xccloop/EdgeLink/edgenode/Drivers/SYSTEM/README.md

# SYSTEM

Put reusable support modules here when needed. No delay, UART, or other
application support code has been generated by the environment setup.
