xccloop/EdgeLink/edgenode/OCD/startup/README.md

# Startup file

`startup_gd32f10x_hd.s` is already present and is the high-density variant for
GD32F103RCT6. The Makefile and linker script are wired for this filename.
