xccloop/EdgeLink/docs/develop/README.md

本文件夹用于记录开发日志
（这里的日志区别于学习日志，主要是写BSP/APP初步写完+硬件初步完成后进行开发尝试）
