xccloop/EdgeLink/OTA_LOG.md

此文件记录OTA升级

BETA:
2026-10-12：V1-V2
compiled.ps1文件第四十一行修改
& $make_path -B SLOT=all IMAGE_VERSION=2 all
此版本不涉及代码修改仅仅为OTA升级测试

2026-10-12：V2-V3
此次将edgenode的HMI先显示启动画面等一切完成后再显示业务画面，不再出现以前的未初始化花屏现象

2026-10-12：V3-V4
此时移除固件传输完毕后自动重启而是等用户自行重启，新增IPS提示

2026-10-12：V4-V5
本次为故障测试用

2026-10-12：V5-V6
本次为故障测试

2026-10-12:V6-V7
修正node的tcp服务器ip

2026-10-14:V7-V8
新增TCP固件链路，修复重连扫描flash异常阻塞

2026-10-14:V8-V9
修复重连扫描flash导致采集发送阻塞的问题

2026-10-14:V9-V10
测试

2026-10-14：V10-V11
修改连接wifi名

2026-10-14:V11-V12
修改连接wifi名
