xccloop/EdgeLink/docs/develop/2026-10-13/main.md

# 2026-10-13

## 今日安排

今天解决两个主线问题

1. 重连扫描flash全部导致异常堵塞
2. TCP链路ota下发
3. 如果有时间研究一下固件签名

先做第二个吧

## 1. TCP链路OTA下发

### 1.1 Node：沿用现有 OTA 流程

昨天我们完成了TCP链路的槽位查询，今天先来想一下接受逻辑
我们知道现有的ota他是存储满768之后然后进行存储，在不改变ota大体框架的情况下，我们进行对于tcp的链路，自然希望也沿用这个设计

```text
存储到768-进行外置flash存储-IPS显示新固件到来-下次重启后bootloader读取新固件
```

这套流程基本上都是可以复用的，唯一要注意的是tcp的堵塞问题
因为我们需要一次存储768个字节，这对于flash的SPI速率来说是有限制的，但是hub的下发又不会停止，就导致数据大量丢失
虽然我们也可以用can的那一套我收到了x序列号固件，但这样做效率还是太低

我们更换思路，人为封装一帧下发给node，node确认完毕之后再继续发，这样做就可以避免刚才的tcp堵塞问题
说着还是挺简单的，让我们来做node适配吧

### 1.2 TCP 帧格式与接收分流

首先我们看一下现有的`ota_tcp_on_frame`，这个函数昨天已经用来处理槽位查询了，所以我们不需要再创建一个入口，直接通过type来区分就好
`0x01`继续处理槽位查询，`0x02`则处理固件数据

不过这里有一个问题，TCP传输的是字节流，我们人为封装的一帧，并不意味着node能一次收到完整的一帧
比如hub发送768个字节，node可能分好几次才收完，所以不能把一次`+IPD`当成一帧固件，我们需要自己把这一帧拼完整

这就需要先确定帧格式，我们除了发送固件本身，还要告诉node这是哪一次传输、第几个块，以及这一块有多少有效数据
因此数据帧就设计为：

```text
type-传输编号-块序列号-有效长度-固件数据
```

这里的768指的是固件数据，不包含前面的帧头
而且最后一块不一定刚好有768个字节，所以有效长度这个字段不能省略，否则node就不知道最后哪些字节才是真正需要存储的

### 1.3 完整块交接与 Flash 写入

接下来就是接收部分，串口中断每收到一个字节，就交给`tcp_receive_byte_from_isr`处理
它先识别type，发现是固件数据以后，先收齐帧头，再根据有效长度把后面的数据收齐
固件里面即使出现了`0x01`或者`0x02`，也不能再当成新的type，因为此时我们已经进入了接收数据的阶段

收齐以后也不能直接在中断里面写flash，中断只负责接收和通知
我们把完整块的位置、长度和连接编号放进队列，由OtaTask取出来，再交给已有的`ota_tcp_on_frame`处理
这里队列传递的是缓冲区的位置，并没有把768个字节再复制进队列，所以在OtaTask处理完成之前，这块接收缓冲不能被覆盖

随后就进入我们熟悉的ota流程了，检查块序列号，检查镜像头，然后调用现有的外置flash写入函数
**注意，回复成功的时间必须放在flash写入成功之后，不能刚收齐数据就告诉hub成功，否则hub继续发送，还是可能遇到缓冲被占用的问题**

回复也不用设计得太复杂，带上对应的传输编号、块号和状态就好
1表示成功，2表示失败，hub收到成功以后才继续发送下一块，没有收到回复就等待超时后重发

### 1.4 重复块与尾块校验

但重发还有一个细节，假如node已经存储成功，只是回复没有到达hub，那么hub就会再发一次相同的块
这时候node不能再推进存储位置，只需要补发一次成功回复，否则同一块固件就会被重复计算

最后一块则需要多做一步，除了把剩余数据写入flash，还要沿用现有的读回CRC校验
只有整个镜像校验通过，才回复最后一块成功，随后IPS提示新固件到来，等待我们手动重启

这样我们增加的主要就是TCP组帧、完整块交接和块号回复，原有的flash存储、镜像校验以及bootloader安装流程都可以继续使用
这里也不需要先断言当前速率一定会大量丢包，我们通过一块一确认，让hub的发送节奏跟随node的实际处理能力，就不用依赖flash每一次都能及时写完了

### 1.5 Hub：HTTP 请求与发送状态

现在我们转头去看hub，node的接受和应答已经处理好了
接下来我们要做的就是hub的crul命令了控制下发

首先这里要区分一下，curl并不直接把固件发送给node，它只是向hub发起一个HTTP请求，告诉hub给哪个node发送哪一个文件
真正读取固件和发送数据的，还是hub自己

因此我们沿用现有的路径：

```http
POST /hub/firmware/tcp/send/node/1
```

这里最后的1就是目标节点编号，请求正文则放hub本地的镜像文件路径
注意，这个路径必须是hub上的路径，不是我们电脑上的路径，而且发送的应该是带镜像头的固件文件

接下来先看HttpHandle，它负责把请求解析成业务意图
发现是TCP下发路径，就从路径中取出node编号，把正文保存为固件路径
这里不打开文件，也不等待node回复，否则HTTP处理函数就会被整个固件传输过程占住

随后Gateruntime拿到这个发送意图，为这次请求分配一个`request_id`，再找到目标node已经建立的TCP连接
这里我们不需要重新连接node，因为node平时上传温度数据用的就是这条连接，固件下发也可以沿用它

找到连接以后，Gateruntime调用ota的`sendFirmwareTcp`，检查文件是否存在、是不是普通文件、长度和镜像头是否合法
检查通过后，把文件句柄、文件总长、目标node和当前块号保存下来

这里需要注意，调用这个函数并不代表固件已经发出去了，它只是建立了本次发送状态
这也是我一开始看ota类比较绕的地方，它并不会自己一直运行，而是由Gateruntime的事件循环不断调用它
第一次调用可能只是建立状态，后面调用时准备数据，收到node回复以后再调用它更新进度
这些调用之间，靠ota对象里面保存的状态衔接起来

其中还有两个编号需要区分，`request_id`用来关联hub内部的HTTP请求，`transfer_id`则会跟着固件帧一起发送给node
前者用于最后找到应该给哪个curl请求返回结果，后者用于判断收到的回复是不是属于这一次固件传输

### 1.6 分块发送与非阻塞续发

状态建立好以后，事件循环开始推进发送
ota从镜像文件的第0个字节开始，每次读取最多768个字节，再按照我们前面约定的格式封装：

```text
type-传输编号-块序列号-有效长度-固件数据
```

普通块的数据长度是768，最后一块则按照文件剩余长度读取
当前块没有确认成功之前，不能推进已确认位置，也不能直接开始准备下一块

封装好以后，ota把数据帧交给Gateruntime，由Gateruntime通过目标连接发送
这也是当前TCP和CAN实现的一处区别，CAN发送时ota可以直接调用`can.send`，而TCP的socket由Gateruntime管理，所以ota负责准备帧，Gateruntime负责真正发送

不过发送这里还有一个细节，hub使用的是非阻塞socket，一次发送不一定能把整帧全部交出去
比如完整帧有777个字节，这次只发出了300个字节，那么下次应该继续发送剩余的477个字节，而不是重新发送一整帧
因此这里还要记录当前已经发送了多少字节，遇到`EAGAIN`就等待可写事件，再继续往后发送
只有整帧都提交给socket以后，才开始计算等待node应答的时间

这里也要区分，发送半帧以后继续发送剩余部分叫续发，完整帧发完但没有收到应答，再从头发送这一块才叫重传

此外这条TCP连接还承载着温度数据的应答，所以固件帧没有发完时，不能把温度ACK插进它的中间
我们让同一连接上的发送数据按顺序进入缓冲，当前帧先发完，再发送后面的内容，这样node才能正确拼出完整帧

### 1.7 回复处理与结果返回

随后hub就等待node的回复了
Gateruntime从TCP字节流中取出完整的8字节回复，再交给ota检查传输编号、块号和状态
如果当前块回复成功，就推进文件位置和块号，下一次事件循环再准备下一块
如果没有收到回复，就等待超时后重发当前块，但重传也要有次数上限，不能一直卡在这里

对于失败回复，我们根据node返回的期待块号处理

- 如果仍然期待当前块，就可以有限次数重发
- 如果node已经清理了接收状态，要求从第0块开始，那么本次传输就结束，等我们下一次重新发起，不在中途自动换成另一场传输

最后一块的成功回复则比较特殊，因为node只有完成整个镜像的Flash读回CRC校验以后才会回复成功
所以hub收到它以后，就可以认为这次镜像接收和校验完成了
**但这仍然不代表新固件已经运行，后面还需要手动重启，由bootloader完成安装和试启动**

最后ota把结果填写到Result里面，Gateruntime根据`request_id`找到等待中的HTTP请求，把结果转换成JSON返回给curl

### 1.8 完整链路与待验证项

这样整条链路就接起来了：

```text
curl发起请求-HTTP解析发送意图-ota建立状态-事件循环分块发送-node写入后应答-hub推进下一块-最后返回下发结果
```

目前两端的代码已经接通，编译和静态审查也完成了，但还没有进行实际下发验证
后面真机验证时，再重点观察块号推进、重复块应答、尾块校验，以及传输中途断线后的重新发送情况

还算是比较简单，基本的链路都可以复用

## 2. 重连扫描外置flash导致异常阻塞的问题

### 2.1 现有阻塞在哪里

接下来我们看一下重连的问题，现在重连以后LogTask会去找没有发送成功的pending记录，然后进行补发
这里有一个问题，现有的`log_find_next_pending`每次读取16个字节，如果没有找到就一直往后找，中间没有主动休眠
而LogTask的优先级为4，IPS和TransmitTask的优先级为3，所以当pending在比较靠后的位置时，LogTask就会连续读取很多次flash，导致其他任务不能及时运行

虽然`gd25_read`每次结束都会释放SPI锁，但释放锁并不意味着LogTask会主动停下来，因此不能只靠这个解决堵塞
当然也不是每次重连都一定扫描完整个日志区，pending数量为0时现在已经会直接返回，主要问题还是有pending但是位置比较分散的情况

### 2.2 先找全，再集中补发

一开始考虑的是找到一条就发送，然后继续找下一条，但我这里希望的是先把所有pending找全，再统一进行补发
比如2号发送失败，3号成功，4号之后又一直失败，那么2号也必须包含在这次补发里面，不能直接从4号开始向后找就结束

因此这里确定为两个阶段：先分步扫描全部日志区，建立索引，扫描完成后再集中补发
补发期间正常采集和发送可以暂时停止，补完以后恢复，但IPS和其他任务还是要能继续运行
**这里的一次性补发是一次触发后持续处理全部pending，发送上仍然沿用现有的一条发送、一条确认，并不是同时把所有记录塞给TransmitTask**

### 2.3 RAM 页位图与空间计算

接下来考虑找到的pending要保存多少信息
如果把所有记录都保存到RAM里面，空间肯定是不够的，甚至只保存每条记录的地址，积压很多的时候也会放不下

现在日志区是[0x000000, 0x3BF000)，后面还有OTA暂存区，因此不能把整颗4MiB都当成日志
一页按256个字节计算，日志区一共有15344页，每页16条记录，也就是245504个槽位

如果每个槽位用一个bit记录有没有pending，需要30688个字节
但芯片总共只有48KB的RAM，现有构建的data和bss已经占了大约25.5KB，剩下还要给主栈等使用，所以这个方案也不合适

我们再缩小一下，不保存每一条的位置，只保存哪一页有pending
每页使用一个bit，15344页只需要1918个字节，这样就比较合适了
这个数组也就是页位图，0表示这一页扫描时没有发现有效pending，1表示这一页至少有一条有效pending

```c
static uint8_t pending_page_bitmap[1918];
```

比如第page_index页，对应数组的`page_index / 8`这个字节，再用`page_index % 8`确定这个字节中的哪一位
补发时根据页号计算地址：`LOG_BASE_ADDRESS + page_index * 256`
这样我们保存的是页的位置，而不是温度、sequence或者每条记录的完整内容

### 2.4 第一阶段：分步扫描，建立完整索引

第一阶段就是建立这个数组
开始新一轮扫描前先清空位图，准备从日志起点开始，pending数量为0时则可以直接结束，不需要白扫一遍
为了让这次扫描的范围稳定，扫描和补发期间先暂停发放新的采集许可，已经产生的采样要先正常落盘，不能因为开始补发就把它丢掉
之前已经投递给TransmitTask的记录仍然可能返回确认事件，这些事件也要正常处理，不能让确认队列一直积压

然后每次从GD25读取一页到256字节缓冲里面，在RAM中检查这一页的16条记录
先判断是不是全FF，再检查CRC，只有有效记录并且状态不是confirmed时，才算pending
发现这一页有pending，就把对应的bit置为1，这个阶段不发送记录

这页检查完成后，`gd25_read`已经释放SPI锁，再调用`vTaskDelay(1)`，让IPS和通信任务有机会运行，随后接着扫描下一页
当前FreeRTOS为1000Hz，1个tick对应1ms，不过`vTaskDelay(1)`是等到下一个tick，并不保证完整睡够1ms
不能拿着SPI锁休眠，否则其他使用SPI的任务还是会被挡住

也不能遇到空槽或者confirmed就停止整个扫描，因为后面仍然可能有零散pending或者回环前留下的记录
一直检查到`LOG_END_ADDRESS`，整个日志区扫描完成，才进入补发阶段

**如果读取失败，这次索引就是不完整的，不能拿它当成已经找全的结果，应该报告存储异常并停止本次流程**

### 2.5 第二阶段：按索引集中补发

第二阶段就是按照这个位图集中补发
先在RAM数组里找到一个标记为1的页，然后从GD25读取这一页，再检查里面具体哪些记录还是pending
这里不能只读数组就直接发送，因为数组只有位置，真正的温度、sequence和状态仍然在flash里面

补发前也要重新检查CRC和状态，因为建立索引以后，之前在途记录的确认事件可能已经把其中一些记录改成confirmed
对于仍然有效的pending，解码成Message，带上它的flash地址，交给现有TransmitTask发送

等到对应地址和sequence的成功结果后，仍然由LogTask调用`log_confirm`，把flash中的状态改成confirmed，pending数量也在确认成功后减少
不能刚放进发送队列就减少pending，也不能收到别的记录的确认就推进当前记录

一条确认完以后，继续检查这一页后面的记录，这一页里面的pending都处理完，再处理下一张有标记的页
这样2号和4号即使中间隔着已经确认的3号，也都会参与补发，页的物理顺序不一定等于回环后的sequence顺序，这里保证覆盖全部，不额外承诺严格按sequence排序

### 2.6 补发期间的调度与缓存

不过补发阶段也不能忘了堵塞的问题
读取一页以后最多检查16条记录，定位范围已经限定在这一页，不会再为了找下一条去连续搜索大量无pending的页
发送等待ACK时现有的队列等待会让任务休眠，IPS可以继续运行，但快速收到ACK时也不能只依赖这个

因此每处理完一张标记页，还是释放总线并休眠1个tick，再继续处理下一页
没有pending的页可以通过RAM位图跳过，不需要重新读取GD25搜索

页缓冲在本页处理结束之前不能被其他函数覆盖，不能把一条记录确认完回来以后，继续解析已经被改掉的缓冲
这一点实现时要检查现有`log_scan_page`的使用位置，必要时给补发单独保留256字节缓冲

### 2.7 失败退出与采集恢复

还有失败以后怎么处理
只有这一页的有效pending都确认成功，才可以清掉这一页的bit，不能发成功一条就清掉整页

暂时沿用现有的连续失败三次退出策略，这时表示本次补发中断，剩余记录仍然是pending，不代表全部补发完成
未处理完的页标记也要保留，下次触发时可以重新建立索引再尝试，不能把失败当成成功跳过去

退出补发以后，恢复采集仍然要经过现有的`log_write_pending_ready`检查，目标扇区还有pending时不能直接擦除
补发过程中再次出现`link_restored`，也不要在当前调用里重新开启一套嵌套扫描，先记住通知，当前流程退出后再判断是否还需要新一轮恢复

### 2.8 RAM 索引与断电恢复

这里我也考虑过把位图存进flash，这样重启以后就不用重建了
但真正需要持久保存的数据本来就在GD25里面，RAM里的位图只是这一轮恢复用的索引

如果这一轮发送失败但没有重启，位图还能保留；如果断电重启，位图虽然没了，但没有确认的记录仍然是pending，重新扫描就能恢复

反而把位图持久化以后，还要考虑记录写成功但位图没更新就断电的情况，直接相信旧索引就可能漏掉记录
所以这次先使用RAM位图，重启仍然沿用开机扫描恢复，不把持久化索引的问题一起加进来

### 2.9 耗时估算与验证边界

最后再区分一下扫描耗时和系统堵塞
当前SPI0为72MHz时钟16分频，也就是4.5MHz，读取一页加上命令和地址，纯传输时间大约0.462ms
实际还有逐字节轮询、函数调用和16条记录的CRC检查，之前估计是1到3ms量级，但这个还没有上板测量，不能当作实测结果或者最大耗时

完整扫描15344页仍然需要等待，如果每页连同调度平均2ms，就大约是30.7秒，这只是举例，不是现在已经测出来的时间
所以这个方案解决的是扫描期间其他任务长时间不能运行，并不会让首次补发立即开始，还是要等页索引全部建立完成
补发总时间也仍然受积压量和ACK速度影响，Flash写擦、SPI锁等待以及发送函数本身的同步耗时也不会因为加了位图就消失

### 2.10 完整流程与测试计划

现在整条流程就确定为：

```text
重连触发-暂停新采集并处理已有采样和确认-每次扫描一页并休眠-建立完整RAM页位图-按位图读取目标页-逐条补发并确认-页间休眠-全部完成或失败退出-检查可写条件后恢复正常采集
```

主要修改集中在`log.c`、`log.h`和`log_task.c`，保留现有16字节记录格式、TCP/CAN发送协议以及ACK确认方式
**目前这里只把修改逻辑整理好了，代码还没有实现，也没有真机验证**

后面重点测试2号失败3号成功4号以后失败这种零散pending，pending位于日志尾部，大量积压，以及日志回环后的情况
再检查扫描和补发期间IPS是否持续刷新，确认事件是否正常处理，一页部分失败时标记是否保留，断电后是否能重新找到未确认记录
同时记录单页扫描耗时、建立索引总时间和补发总时间，再根据实际结果调整每页之间的等待

### 2.11 代码实现

接下来按照这个方案把代码接上了
`log.c`里面增加了1918字节页位图和独立的256字节补发缓存，`log_pending_scan_begin`开始新一轮建图，`log_pending_scan_step`每次最多读取一页
这一步只建立索引，不发送，全部完成后才能使用`log_pending_replay_next`按标记页取记录
它返回`LOG_MORE`时表示还要继续，和`LOG_NO_PENDING`区分开，LogTask会先休眠1个tick再继续
原来重连入口先调用`log_find_oldest_pending`，现在已经替换成暂停采集、完整建图、集中补发，不会先走一遍旧的无休眠搜索

上电恢复则直接复用`log_init`扫描时顺便建立的位图，避免开机再扫一次，不过原有开机恢复扫描本身仍然是同步的，这次没有把它也改成分步初始化
确认事件在扫描页之间也会处理，如果另一条在途记录恰好属于当前补发缓存页，确认成功后会同步修改缓存状态，后面就不会再按旧状态把它取出来

暂停采集时也处理了已经发出去的许可，没有被CollectTask取走就撤回，已经取走就等待这次采样落盘或者失败归还许可，之后不再发新许可
补发结束或者连续失败三次退出后，仍然先检查下一个槽位是否可写，再恢复采集

### 2.12 编译、主机回归与待做的真机验证

现在plain、A、B三种布局编译通过，data为116字节，bss为28232字节，静态RAM合计28348字节，大约27.7KB

新增了`test_log_replay.py`，使用模拟GD25和队列运行真实`log.c`、`log_task.c`，检查每次扫描最多一页，完整扫描完成前不开始补发
零散pending、日志最后一页、同页多条、其他记录的确认更新缓存、连续失败三次后重新恢复、扫描读取失败和CRC损坏都做了主机回归
还检查了撤回采集许可、失败归还许可，以及已经在途的采样先落盘，最后跑了LogTask上电、重连、恢复采集这一条调用流程

这些主机测试通过，原有TCP重连回归也通过，代码和安全并行审查没有发现需要修复的高、中风险问题

**这里模拟的仍然是主机队列和flash，不能证明真实FreeRTOS抢占、单页最大耗时或者IPS已经不再卡顿**
下一步需要烧录后制造零散和大量pending，观察重连建图期间IPS是否持续刷新，建图完成后积压是否逐步减少，再保留扫描耗时、串口和Hub确认记录
