xccloop/EdgeLink/docs/develop/2026-10-14/main.md

2026-10-14

昨天写的一个新功能和修复一个bug还没有进行测试
今天先进行测试，然后把固件签名给做好

## 1.补发期间继续采集和正常发送

先测试了昨天的重连处理，发现现在重连时已经不会严重卡死，HMI和LED还能运行
但温度采集和新的记录会停下来，pending也不会继续增加，只有历史pending补发完以后才恢复
这里要分清楚，这不是LogTask死锁，而是昨天确定的暂停采集策略，CollectTask没有得到新的许可，所以没有产生这段时间的样本
现在我希望把这段采样空窗去掉，历史恢复期间新采样也照常落盘和发送

### 修改思路

不能只在原来的补发循环里增加休眠，因为那样只是让其他任务能运行，LogTask还是没有回来处理新采样
因此把补发拆成空闲、建图、找下一条、等待投递、等待结果这几个状态，每轮主循环只推进一步
主循环先处理确认，再处理新采样和正常发送，最后推进历史扫描或者补发
等待历史ACK的时候，不再让LogTask停在confirm_queue的portMAX_DELAY上，真正的网络等待还是交给TransmitTask

这里也要考虑新数据不断增加的问题，不能用全局pending数量归零来判断历史是否补完，否则新采样会让这一轮一直结束不了
我们在开始建图时记住当前最大已落盘sequence，比如100，这次只处理不超过100的历史记录
之后101、102这些仍然正常落盘和发送，但不加入这一次历史补发，发送失败也保留在Flash里面
等后续正常通信成功或者再次重连时，再安排新一轮恢复，离线期间不自动无限循环建图

### 队列、缓存和空间边界

正常工作优先，历史最多一条在途，已有正常发送结果都处理完以后才投递历史，避免同一条旧记录的结果相互混淆
队列投递改成零等待，满了就把已经落盘的普通工作保留在LogTask里，下一轮再试，不能丢掉也不能直接当成发送成功
这时暂缓下一次采集许可，这是实际发送容量不足产生的背压，和每次补发都主动暂停采集不同
如果普通数据长期占满链路，历史发送也可能一直等不到空隙，这个要靠实测吞吐判断，不能保证两路都不受带宽限制

允许新写入以后，原来每写一条就把索引置为无效的逻辑也要去掉，改成只处理固定历史范围
同页追加或者整扇区擦除会使对应补发缓存失效，但保留游标，下一次重新读取实际内容
其他确认仍然按地址和sequence检查，槽位已经擦掉或者复用了就返回LOG_STALE，不修改新记录，也不把这种旧结果当成Flash读取失败
目标扇区仍然含pending时继续禁止擦除，用LOG_FULL和真正的IO失败区分，等确认释放空间以后再重新检查采集许可
历史记录连续失败三次仍然结束本轮恢复，不影响正常主循环继续处理采集和发送

上电初始化也一起接上，恢复序号以后先放行HMI和可写时的采集，再单步推进历史发送，不再补完全部记录以后才放行
不过上电那次恢复写指针和sequence的全区扫描本身没有改成异步，这个和运行期补发分开看

### 实现和验证

主要修改了log_task.c、log.c和log.h，没有增加任务，也没有修改16字节记录、TCP/CAN帧或者线上ACK
主机回归先复现了扫描期间写入新样本会混入历史范围的问题，再检查新样本不会使快照失效、不会延长这一轮历史
随后用模拟GD25、有限队列和模拟调度运行真实LogTask，检查扫描和历史ACK等待期间继续产生、落盘并投递正常记录
还覆盖了历史连续三次失败、队列满后重新投递、同页追加、整扇区复用、旧确认、空日志以及读取失败
满扇区的测试保留了暂停保护，并检查历史确认释放空间后采集许可能够重新发出
日志、TCP重连和OTA手动重启三项主机回归通过，plain、A、B三种APP编译通过，代码和安全并行审查没有发现需要修复的高、中风险问题
以上是主机模拟和编译结果，实际运行情况继续结合下面的实测观察记录，不能直接当成所有场景都已经通过。

### 实测观察和恢复版本

之前看到BACKLOG没有变化，以为采集和发送又卡住了，后来确认其实数据已经发出去了。
持续采集版也观察到BACKLOG反复0和1跳变有所改善，因此暂时撤回回退决定，恢复持续采集版继续测试。
BACKLOG显示的是未确认记录总数，新记录增加和历史确认减少可能相互抵消，不能只看这个数字判断是否卡死。

分步扫描后偶尔仍有短暂停顿，IPS和LED都会停一下。目前感觉主要影响观感，也不是不可接受。
先检查代码中没有分步的路径：

- 进入扇区前的pending检查会连续读完整4KiB，最多16页，中间没有休眠；可写检查和实际写入前都可能执行。
- GD25写入和扇区擦除仍在等待WIP清零时忙等，LogTask优先级4高于HMI的3和LED的2，可能同时推迟屏幕刷新和LED任务。
- 每条新记录的printf也是轮询串口发送；一轮还可能连续处理多条确认，每条确认都要写Flash。

这些是源码发现的候选原因，目前没有测出真机各段耗时，不能直接把偶发卡顿归到其中一个。
IPS使用SPI2，Flash使用SPI0，这里不能直接归因于屏幕和Flash抢同一条SPI总线。

### 当前决定

先保留补发期间继续采集和正常发送这一版，不再回退，也暂时不继续修改驱动。
偶发卡顿先记作待优化项，目前没有测出具体耗时，也还没有确认是哪一段造成的。
后面如果出现明显长停顿，或者发现采集、通信受到影响，再测量单页扫描、扇区检查、擦除、写入、确认和串口打印的最长耗时，找到原因以后做局部修改。

这次也提醒我，不能只看BACKLOG数字有没有变化来判断系统是否卡死，还要结合Hub是否持续收到数据、采样序号是否增长。
现在只记录已经观察到的现象，持续采样、大量积压和空间边界等情况还需要继续验证。

## 2.测试TCP下发固件

今天测试Hub通过TCP给3号Node下发A槽v9固件，命令如下：

```powershell
curl.exe -i -X POST http://192.168.1.4:8080/hub/firmware/tcp/send/node/3 --data-raw "/home/root/firmware/node_a_v9.bin"
```

返回结果：

```http
HTTP/1.1 200 OK
Content-Length: 74
Connection: keep-alive
Content-Type: application/json
Keep-Alive: timeout=4
Proxy-Connection: keep-alive

{"submitted":true,"node":3,"submitted_bytes":49480,"relay_verified":true}
```

这次TCP下发正常，49480字节的镜像已经提交，Node返回中转镜像校验成功。
这里确认的是TCP传输和中转区校验这一段，重启后的Bootloader安装、实际运行版本和试运行确认还要结合节点状态判断，不能只靠这个HTTP返回就认定全部升级完成。

### 掉电保护测试范围

这次TCP OTA不再重复做掉电保护测试。之前CAN OTA已经尝试过接收中途断电、Bootloader搬运中途断电后恢复等情况，相关记录见[10月12日开发笔记](../2026-10-12/main.md)。
TCP和CAN接收后使用相同的中转镜像、Bootloader安装和恢复逻辑，所以这次先复用之前公共流程的验证记录，重点确认TCP下发是否正常。
不过TCP自身接收中断、重连等情况不等于已经通过掉电测试，这部分仍然记为本次未测。

## 3.增加OTA固件签名

TCP下发已经测试到中转镜像校验成功，接下来补上固件来源认证。之前只有CRC，别人修改固件以后重新计算CRC还是能通过，所以现在增加ECDSA P-256和SHA-256。

库源码也放在Common里面，具体是Common/Crypto/micro-ecc和Common/Crypto/sha256。Common/OTA负责签名格式、固定公钥和分块验签接口，APP和Bootloader各自编译同一份源码，不在设备上保存私钥。

### 打包和校验逻辑

镜像头格式升到v2，总长仍然256字节。前28字节的原字段不动，随后增加4字节算法编号和64字节签名，剩下156字节保留区，最后还是header_crc32。
签名覆盖清零签名字段后的前252字节镜像头和完整APP，绑定型号、版本、目标槽、长度和应用内容。私钥签名以后填入签名，最后再计算头CRC。

私钥生成在仓库外的本机.edgelink/keys/ota-signing.pem，仓库只保留公钥。compiled.ps1仍然可以用-v10编译，也能通过-SigningKey指定私钥路径。缺少私钥或者公私钥不配对会报错，不生成无签名镜像。

校验分三处：

1. APP收完以后，从GD25读回镜像头和完整应用，验签成功才认为接收完成、提示重启。
2. Bootloader搬运前重新读取中转镜像并验签，失败不能擦除目标槽。
3. 搬运后及每次启动检查内部A/B槽时验签，回退槽也要通过校验。

Hub最初只同步接受v2镜像头，随后补上了下发前的完整验签，具体见下面的补充记录。TCP和CAN帧格式没有改变。

### 容量和验证

最初只给密码学库开启体积优化，Bootloader超出16KiB约468字节；改为Bootloader整体使用-Os后能够放下，分区地址没有调整。
编译器栈报告显示验签多了大整数运算的调用层次，因此OtaTask从512words增加到768words，也就是3KiB，实际最低栈水位仍要上板观察。

主机测试使用独立测试密钥，已经检查正确签名、错误密钥、旧格式、损坏签名，以及修改应用或镜像头再重新计算CRC后仍被拒绝。
还运行真实APP的CAN/TCP接收路径和Bootloader安装/槽校验路径，检查坏签名不能返回成功、不能触发目标槽擦除、不能启动内部假镜像。
签名库的版本和许可证保留在Common/Crypto中，SHA-256做了标准头文件移植和字节移位前转无符号的局部修正。

首次启用要配套烧录新Bootloader和签名APP，同时更新Hub，旧无签名APP不会被新Bootloader接受。还没有做签名版本的实机升级、验签耗时和栈水位测试；今天前面TCP下发成功的记录对应的是增加签名之前的版本。
这次先解决网络伪造固件，不加入防回滚、固件加密和SWD物理防护。

最终验证：签名交叉校验、Bootloader验签、OTA接收与重启提示、日志补发、TCP重连五项主机回归通过；compiled.ps1 -v10编译plain/A/B通过，A/B镜像主机验签通过，Bootloader产物15464字节，Hub在WSL原生编译通过。代码和安全审查未发现高、中风险问题，SHA-256移位问题已修正。这些修改尚未烧录，也没有部署到Hub。

### 这次遇到的问题

一开始感觉就是加一个库然后调用函数，真正接进去以后发现，算法调用本身比较简单，反而是空间、栈和两边格式一致这些地方需要处理。

#### 1.Bootloader空间不够

Bootloader只预留了16KiB，最初只给密码学库加-Os，其余代码仍然按原来的-Og编译，链接时报FLASH超出468字节。
这里没有直接扩大Bootloader分区，因为那样会牵动A/B地址、链接脚本和现有镜像。
最后把Bootloader整体改为-Os，保留调试符号，产物缩到15464字节，距离16KiB上限还剩920字节，原来的分区布局不用改。
后面再给Bootloader加功能时要注意这部分余量，已经不能随便增加了。

#### 2.验签增加了任务栈需求

原来的OtaTask只有512words，也就是2KiB栈。加入验签以后，除了读回镜像头和SHA-256上下文，还有ECDSA大整数运算的多层调用。
编译器栈报告里，ota_finalize自身使用472字节，uECC_verify自身使用536字节，这些数字还不能直接当成整个任务的峰值，调用它们的函数和更深层运算也要算进去。
所以把OtaTask增加到768words，也就是3KiB，先给验签留出余量。这个是根据静态报告做的调整，还没有测真机最低栈水位，不能只凭编译通过就说栈一定够。

#### 3.库移植和审查发现的小问题

SHA-256库使用memory.h，当前ARM工具链没有这个头文件，编译直接失败。实际需要的只是内存操作接口，改用标准C的string.h以后编译通过。
审查还发现，拼接32位字时，字节直接左移会先提升成有符号int，高位字节较大时存在未定义行为。这里改为先转成无符号WORD再移位，并把本地修改记在库的UPSTREAM.md里面。
修改后重新运行签名测试和编译，避免只修掉报错却改变摘要结果。

#### 4.编译通过，编辑器却找不到sha256.h

后来编辑器在ota_signature.h里面提示sha256.h找不到，但是Makefile编译是通过的。
排查后发现，Makefile已经加入密码学库的搜索路径，编辑器使用的Clang分析环境没有同步找到它，所以这是头文件搜索路径的问题。
最后把Common内部的引用改为相对路径，ota_signature.h引用../Crypto/sha256/sha256.h，ota_signature.c引用../Crypto/micro-ecc/uECC.h。
用不额外添加库搜索目录的语法检查先复现报错，修改后检查通过，签名回归和Bootloader编译也通过。

#### 5.签名覆盖范围和校验入口要统一

镜像头里放一个签名成员只是保存结果，真正要保护的是头字段和完整应用。签名字段本身要清零参与摘要，最后的头CRC不参与签名，否则会出现循环依赖。
APP收到镜像头时还不能完成验签，要等应用收完，再从Flash读回完整内容。Bootloader搬运前和内部槽启动前也要检查，回退路径不能漏掉。
这里用Common中的同一套分块接口统一规则，再用Python签名和真实C验签交叉检查，防止脚本和设备看起来都实现了签名，实际计算的字节却不一样。

这次签名实现和修改有AI协助，主机测试及编译结果已经记录，但签名版本还没有上板。接下来仍然要确认正确签名可以升级、假镜像会被拒绝，以及实际验签耗时和栈水位。

### 补充Hub下发前验签

Hub原来下发前就会检查镜像，这次增加签名以后也要同步。只检查v2格式、长度和头CRC还不够，Hub也要在发送前验证完整固件的签名。

现在Hub增加OtaImageVerify.c，分块读取镜像文件，验证头CRC、完整APP的CRC和签名。最初把它接到了edgenode/Common的源码，随后发现这样破坏了Hub和Node作为两个独立项目的边界，已经改成Hub自己的本地副本，且不保存私钥。
CAN和TCP下发共用这个检查，全部通过以后才进入发送状态，失败返回InvalidImage。Node自己的接收读回和Bootloader验签继续保留，不能因为Hub检查过就省掉。

主机回归运行真实OTA.cpp的CAN/TCP下发入口，使用测试密钥和假的CAN发送函数，检查正确签名能启动发送，错误密钥、旧格式、修改头字段或应用后重新计算CRC都被拒绝。回归、Hub原生编译及龙芯交叉编译通过，代码和安全审查未发现本次新增的高、中风险问题，目前没有部署到Hub实测。

### Hub和Node保持独立

Hub和Node是两个项目，Hub构建不应该去引用Node目录。之前直接引用Common的做法虽然能编译，但是只复制Hub到别的机器就不行了，这里需要改掉。
现在Hub在自己的tools/crypto中保存SHA-256和micro-ecc，在tools/ota中保存镜像格式、验签接口、CRC和公钥。CMake只使用Hub里面的文件，测试也自己生成签名镜像，不再import Node的打包脚本。
Node自己的库仍然放在Common里面，不移动。两个项目独立保存源码，但镜像格式和信任公钥必须保持一致，之后修改时也要同步检查。

独立性验证：只把edgehub复制到临时目录，旁边不放edgenode，分别完成原生构建、龙芯交叉构建和签名回归，全部通过。代码及安全复查也没有发现新增问题，尚未部署到设备。

## 4.ESP串口和TCP故障排查

新Bootloader已经在设备上验过中转镜像、搬运到B槽并跳转到0x08021900，应用采集和CAN回退也在运行。不过TCP最初的AT测试收不到OK，关闭旧连接和重启ESP的步骤随后也超时。
用ping 192.168.1.106并对照整板断电，上电后恢复回应，确认该IP属于板上的ESP，说明Wi-Fi入网和ICMP回应正常。现在故障更偏向MCU和ESP之间的AT通信，不能只看IPS的--就说没有入网。

当前esp12s_init只配置MCU串口，不检测ESP是否响应。增加了串口配置完成、AT检查成功的分开提示，并在等待超时和恢复失败时打印[esp uart]计数：等待期间收到的字节、总接收字节、文本行、识别事件、队列丢弃、帧错误、接收溢出、IPD剩余字节和未完成文本行长度。
诊断不打印原始串口内容，避免把密码回显打出来，也暂时不修改原来的恢复和解析策略。rx=0只说明等待期间ISR没取到字节，不能直接判定ESP损坏；rx增加但events不增加时继续查解析或波特率；ipd_left不归零时查残留负载状态。
主机检查覆盖实际USART ISR计数、原ESP/TCP解析、TCP恢复、日志补发和OTA接收；五项回归和三种APP编译通过，B签名镜像主机校验通过，代码及安全审查没有新增高、中风险问题。
诊断固件已生成但尚未烧录，目前TCP未恢复，原因仍待板端计数确认。
