xccloop/EdgeLink/docs/develop/2026-09-22/main.md

# 2026-09-22 调试笔记

今天吧四块板子都进行了验证测试，还挺顺利，遇到的问题都是焊接出现问题，毕竟软件固定下来要是不能运行就只能是硬件出错
