xccloop/EdgeLink/docs/develop/2026-10-12/images/LS2K0300上运行http请求正常回复.png

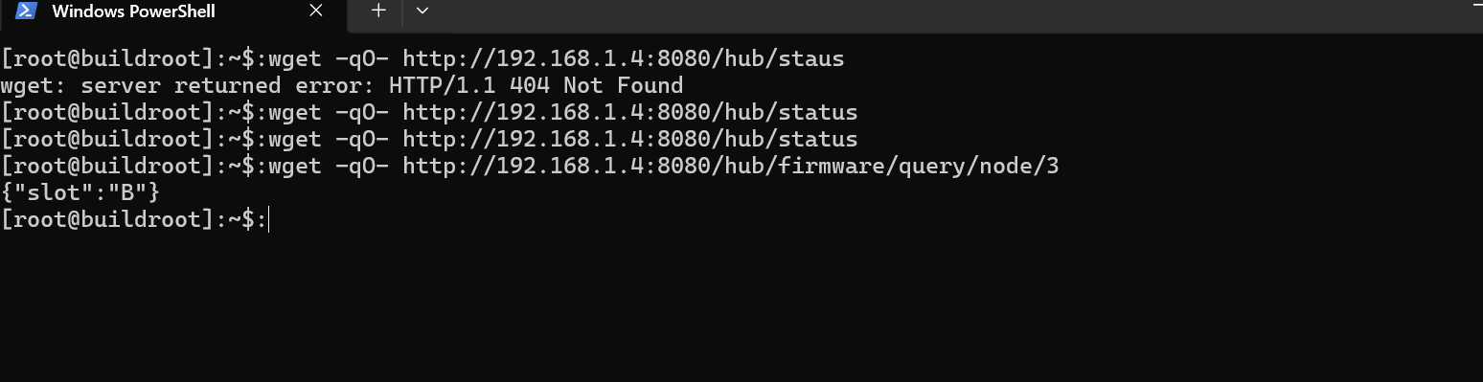
docs/develop/2026-10-12/images/LS2K0300上运行http请求正常回复.png
