xccloop/EdgeLink/docs/develop/2026-10-12/images/TCP_CAN双链路查询返回结果通过.jpg

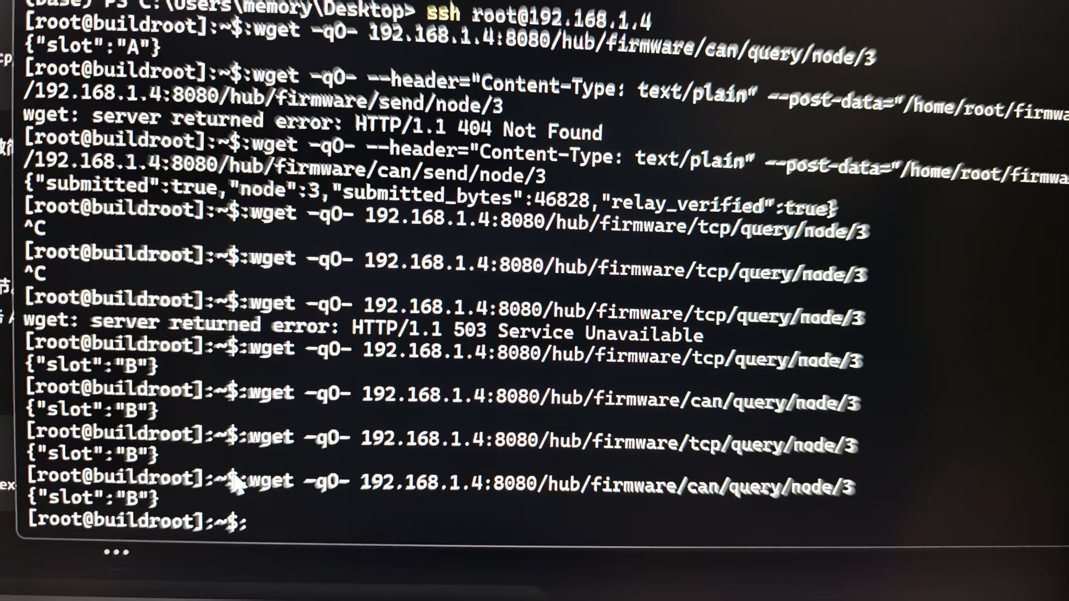
docs/develop/2026-10-12/images/TCP_CAN双链路查询返回结果通过.jpg
