xccloop/EdgeLink/docs/develop/2026-10-12/images/新版本V2的IPS显示.jpg

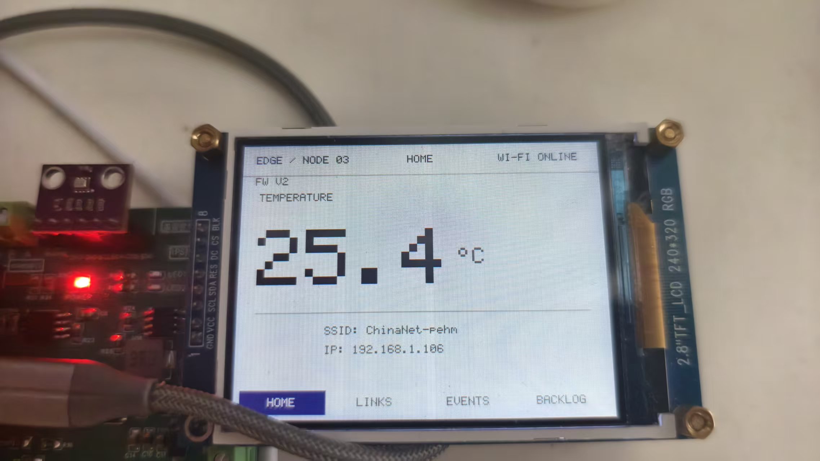
docs/develop/2026-10-12/images/新版本V2的IPS显示.jpg
