xccloop/EdgeLink/edgedash/resources/ChatGPT 图像 2026年9月29日 09_41_02.png

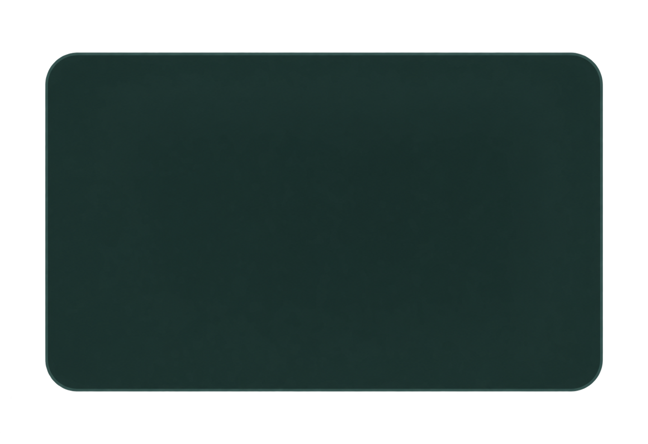
edgedash/resources/ChatGPT 图像 2026年9月29日 09_41_02.png
