xccloop/EdgeLink/edgedash/resources/Green and White Modern Simple Startup Pitch Deck Business Presentation/5.png

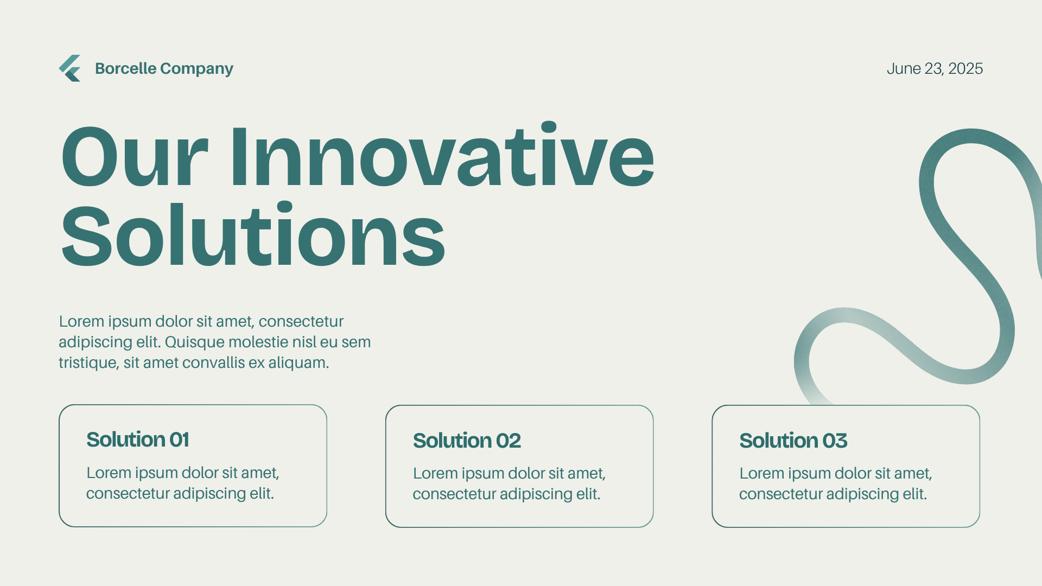
edgedash/resources/Green and White Modern Simple Startup Pitch Deck Business Presentation/5.png
