xccloop/EdgeLink/edgedash/resources/Green and White Modern Simple Startup Pitch Deck Business Presentation/14.png

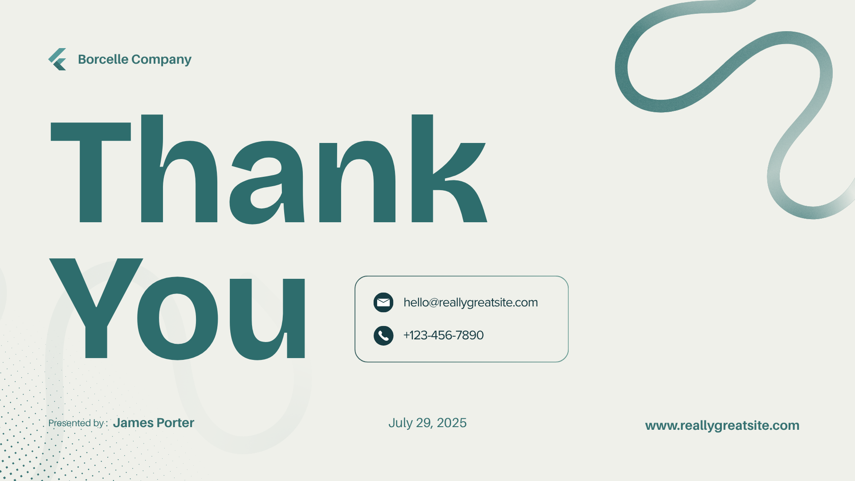
edgedash/resources/Green and White Modern Simple Startup Pitch Deck Business Presentation/14.png
