xccloop/EdgeLink/edgedash/resources/Green and White Modern Simple Startup Pitch Deck Business Presentation/EdgeDash 网络信息面板.png

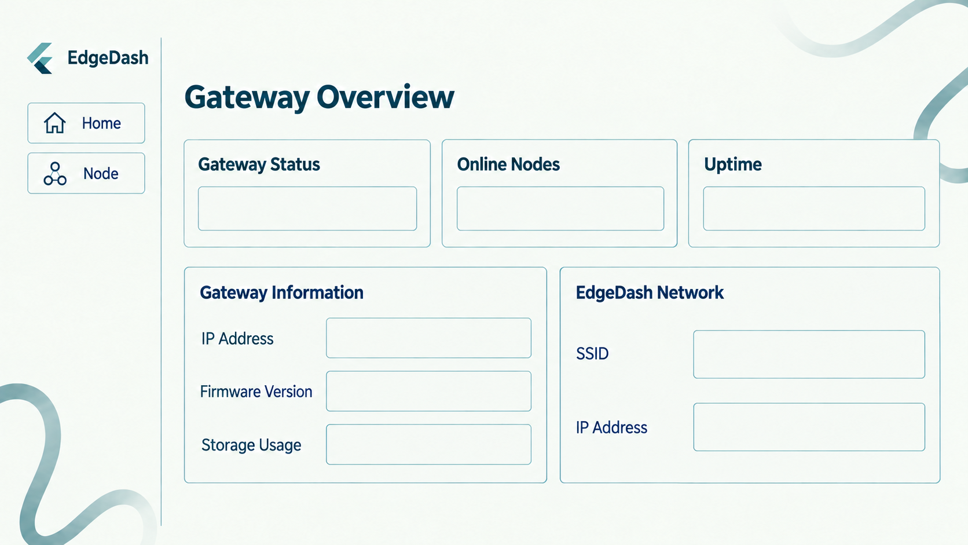
edgedash/resources/Green and White Modern Simple Startup Pitch Deck Business Presentation/EdgeDash 网络信息面板.png
