xccloop/EdgeLink/edgedash/resources/Green and White Modern Simple Startup Pitch Deck Business Presentation/EdgeDash侧栏新增Setting按钮.png

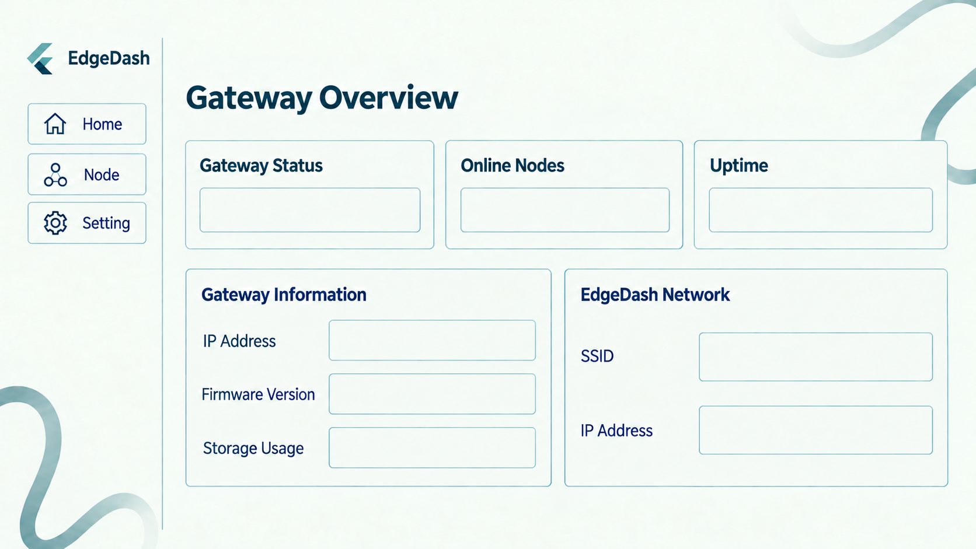
edgedash/resources/Green and White Modern Simple Startup Pitch Deck Business Presentation/EdgeDash侧栏新增Setting按钮.png
