xccloop/EdgeLink/edgedash/resources/Green and White Modern Simple Startup Pitch Deck Business Presentation/mainwindow.png

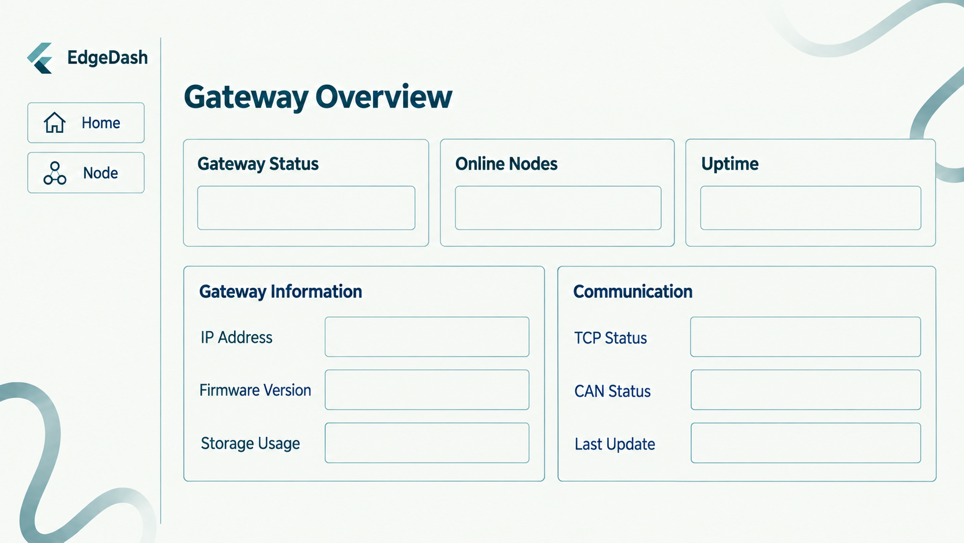
edgedash/resources/Green and White Modern Simple Startup Pitch Deck Business Presentation/mainwindow.png
