xccloop/EdgeLink/edgedash/resources/main_backround.png

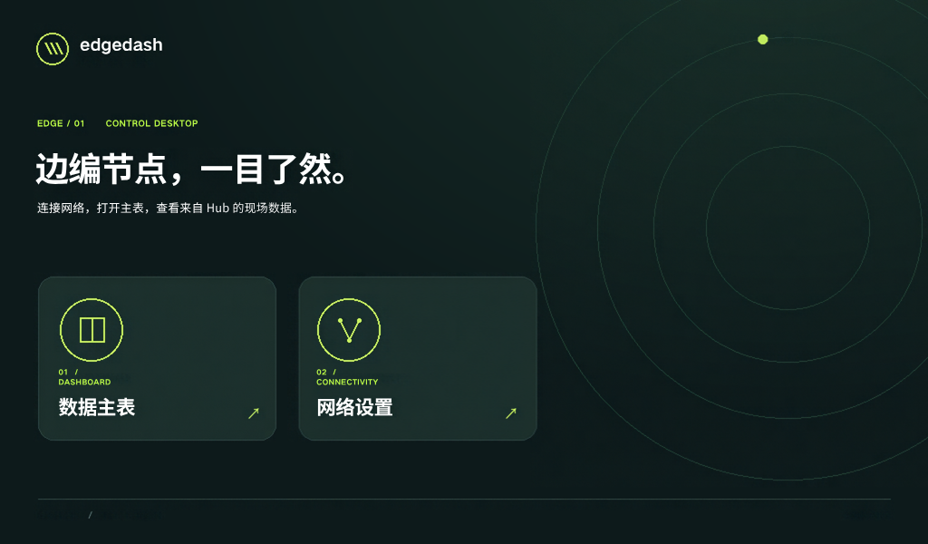
edgedash/resources/main_backround.png
