xccloop/EdgeLink/docs/develop/2026-10-10/TEST/test5/序列号6w截屏.png

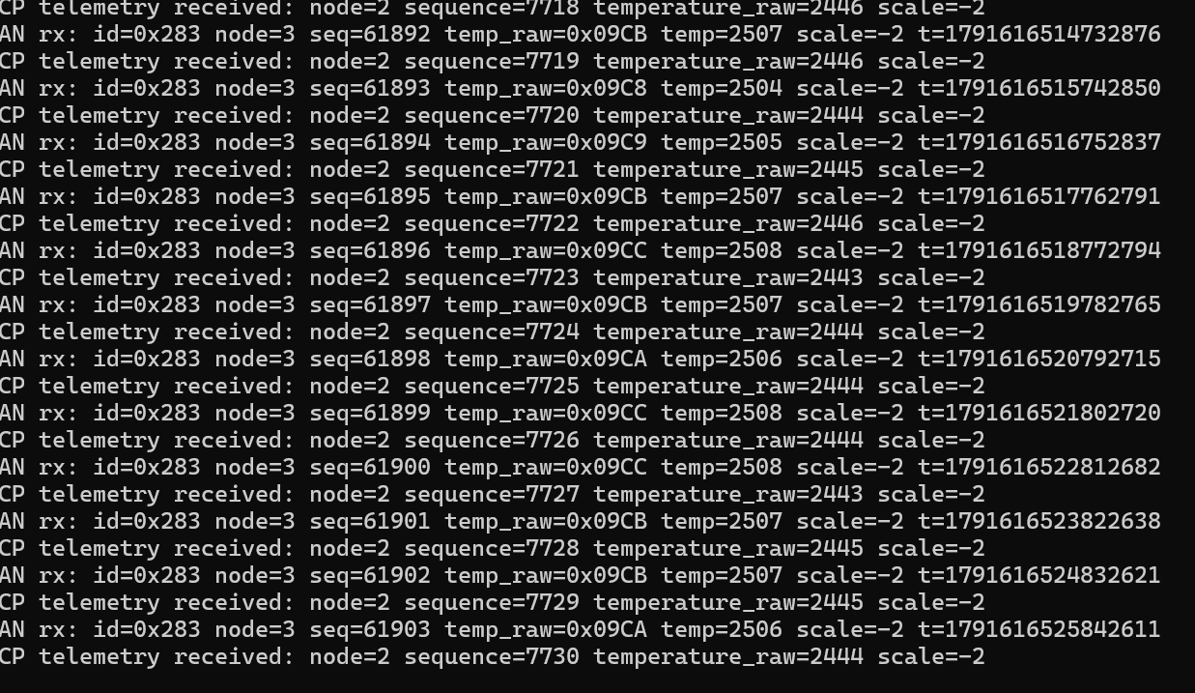
docs/develop/2026-10-10/TEST/test5/序列号6w截屏.png
