xccloop/EdgeLink/edgenode/User/App/Output/Tcp/tcp.c

#include "tcp.h"
#include "ESP12S/esp12s.h"
#include "INTERRUPT/USART/usart.h"
#include "board_time.h"
#include "FreeRTOS.h"
#include "task.h"

#include <stddef.h>
#include <stdint.h>
#include <stdio.h>

/*
    这里我们先把TCP初始化中的代码来源分清楚，避免后续学习时把所有内容都理解成ESP12S固定要求。
    AT、CWMODE、CWJAP、CIFSR、CIPMUX、CIPMODE和CIPSTART是按照ESP-AT建立单连接普通模式TCP的命令流程，
    esp12s_init()和esp12s_cmd_send()是调用现有BSP的接口；它们是这次初始化真正需要做的事情。
    tcp_command_send_and_wait_ok()和tcp_wait_response()不是ESP12S的API，而是为了让上面的命令能一条一条顺序完成：
    发送后就停在这里等待，成功才执行下一条，失败或超时就立刻从tcp_init()返回。这样APP调用一次tcp_init()，
    从上到下读到的就是实际AT流程，不需要TCP_STATE和tcp_service()这套非阻塞状态机。
    USART1中断仍然需要逐字符拼出OK、ERROR、CONNECT等完整回应，因为串口不会一次送来完整字符串；中断把已经识别的结果
    放进回应队列，等待函数再顺序取出。这个队列不是为了把初始化改复杂，而是避免ESP连续返回CONNECT和OK时前一个结果被覆盖。
    后续移植FreeRTOS后，当前while等待可以替换为“任务等待通知或队列”，初始化代码的AT命令顺序仍然可以保持不变。
*/

#define TCP_AT_TIMEOUT_MS       10000U
#define TCP_WIFI_JOIN_TIMEOUT_MS 50000U
#define TCP_COMMAND_BUFFER_SIZE 128U
#define TCP_SSID_SIZE 33U

/* 断线重连比首次建连短：网关不在时也要尽快把发送任务交还给调用方。 */
#define TCP_RECONNECT_TIMEOUT_MS 5000U

static char tcp_command_buffer[TCP_COMMAND_BUFFER_SIZE];
static uint8_t tcp_connected;
static uint8_t wifi_connected;

static char tcp_ssid_saved[TCP_SSID_SIZE];//存储ssid

/* tcp_init() 校验通过的配置留一份，重连时只需重发 CIPSTART，不必重跑 CWJAP。 */
static const tcp_config_struct *tcp_saved_config;

typedef enum
{
    TCP_RECOVERY_IDLE,
    TCP_RECOVERY_CLOSE,
    TCP_RECOVERY_CONNECT,
    TCP_RECOVERY_RESET,
    TCP_RECOVERY_STATION,
    TCP_RECOVERY_JOIN,
    TCP_RECOVERY_MUX,
    TCP_RECOVERY_MODE,
    TCP_RECOVERY_ADDRESS,
    TCP_RECOVERY_LOCAL_INFO,
    TCP_RECOVERY_STATUS,
    TCP_RECOVERY_AP,
    TCP_RECOVERY_POWER,
    TCP_RECOVERY_VERSION
} tcp_recovery_state_t;

static tcp_recovery_state_t recovery_state;
static uint32_t recovery_started_ms;
static uint32_t recovery_wait_ms;
static uint8_t recovery_attempts;
static uint8_t recovery_ack_misses;
static uint8_t recovery_connect_seen;
static uint8_t recovery_ok_seen;
static esp12s_uart_health_t recovery_uart_before;

static void tcp_uart_health_print(const char *reason,
                                   const esp12s_uart_health_t *before)
{
    esp12s_uart_health_t now;
    esp12s_uart_health_get(&now);
    printf("[esp uart] %s rx=%lu total=%lu lines=%lu events=%lu drop=%lu ferr=%lu oerr=%lu ipd_left=%u line=%u overflow=%u\r\n",
           reason,
           (unsigned long)(now.rx_bytes - before->rx_bytes),
           (unsigned long)now.rx_bytes,
           (unsigned long)(now.text_lines - before->text_lines),
           (unsigned long)(now.events - before->events),
           (unsigned long)(now.dropped_events - before->dropped_events),
           (unsigned long)(now.framing_errors - before->framing_errors),
           (unsigned long)(now.overrun_errors - before->overrun_errors),
           (unsigned int)now.ipd_remaining,
           (unsigned int)now.partial_line_length,
           (unsigned int)now.line_overflow);
}

static void tcp_diagnostic_print(void)
{
    char line[ESP12S_DIAGNOSTIC_LINE_SIZE];
    uint8_t count;
    for(count = 0U; count < 8U; count++)
    {
        if(esp12s_diagnostic_get(line, sizeof(line)) == 0U) break;
        printf("[tcp net] %s\r\n", line);
    }
}

static const char *tcp_response_name(esp12s_response_t response)
{
    switch(response)
    {
        case ESP12S_RESPONSE_OK: return "OK";
        case ESP12S_RESPONSE_ERROR: return "ERROR";
        case ESP12S_RESPONSE_FAIL: return "FAIL";
        case ESP12S_RESPONSE_PROMPT: return "PROMPT";
        case ESP12S_RESPONSE_SEND_OK: return "SEND OK";
        case ESP12S_RESPONSE_CONNECT: return "CONNECT";
        case ESP12S_RESPONSE_CLOSED: return "CLOSED";
        case ESP12S_RESPONSE_WIFI_CONNECTED: return "WIFI CONNECTED";
        case ESP12S_RESPONSE_WIFI_GOT_IP: return "WIFI GOT IP";
        case ESP12S_RESPONSE_BUSY: return "BUSY";
        case ESP12S_RESPONSE_READY: return "READY";
        default: return "UNKNOWN";
    }
}

static uint8_t tcp_recovery_command(tcp_recovery_state_t state)
{
    const char *command = NULL;
    int length = 0;

    switch(state)
    {
        case TCP_RECOVERY_CLOSE: command = ESP_AT_CIPCLOSE; break;
        case TCP_RECOVERY_RESET: command = ESP_AT_RST; break;
        case TCP_RECOVERY_STATION: command = "AT+CWMODE=1\r\n"; break;
        case TCP_RECOVERY_MUX: command = "AT+CIPMUX=0\r\n"; break;
        case TCP_RECOVERY_MODE: command = "AT+CIPMODE=0\r\n"; break;
        case TCP_RECOVERY_ADDRESS: command = "AT+CIPSTA?\r\n"; break;
        case TCP_RECOVERY_LOCAL_INFO: command = ESP_AT_CIFSR; break;
        case TCP_RECOVERY_STATUS: command = "AT+CIPSTATUS\r\n"; break;
        case TCP_RECOVERY_AP: command = "AT+CWJAP?\r\n"; break;
        case TCP_RECOVERY_POWER: command = "AT+SLEEP?\r\n"; break;
        case TCP_RECOVERY_VERSION: command = "AT+GMR\r\n"; break;
        case TCP_RECOVERY_JOIN:
            length = snprintf(tcp_command_buffer, sizeof(tcp_command_buffer),
                              "AT+CWJAP=\"%s\",\"%s\"\r\n",
                              tcp_saved_config->wifi_ssid, tcp_saved_config->wifi_password);
            command = tcp_command_buffer;
            break;
        case TCP_RECOVERY_CONNECT:
            length = snprintf(tcp_command_buffer, sizeof(tcp_command_buffer),
                              "AT+CIPSTART=\"TCP\",\"%s\",%u\r\n",
                              tcp_saved_config->server_ip,
                              (unsigned int)tcp_saved_config->server_port);
            command = tcp_command_buffer;
            break;
        default: return TCP_FAIL;
    }
    if((length < 0) || ((uint32_t)length >= sizeof(tcp_command_buffer)))
    {
        printf("[tcp recovery] command buffer error stage=%u\r\n", (unsigned int)state);
        return TCP_FAIL;
    }
    recovery_state = state;
    recovery_started_ms = board_systick_ms;
    recovery_wait_ms = (state == TCP_RECOVERY_JOIN) ? TCP_WIFI_JOIN_TIMEOUT_MS :
                       (state == TCP_RECOVERY_RESET) ? 15000U :
                       (state == TCP_RECOVERY_CONNECT) ? TCP_RECONNECT_TIMEOUT_MS : TCP_AT_TIMEOUT_MS;
    recovery_connect_seen = 0U;
    recovery_ok_seen = 0U;
    esp12s_response_reset();
    esp12s_uart_health_get(&recovery_uart_before);
    /* Only CIPSTART is logged: CWJAP contains the WiFi password. */
    if(state == TCP_RECOVERY_CONNECT)
    {
        printf("[tcp recovery] command=%s", command);
    }
    esp12s_cmd_send(command);
    printf("[tcp recovery] stage=%u attempt=%u\r\n", (unsigned int)state,
           (unsigned int)recovery_attempts);
    return TCP_SUCCESS;
}

static void tcp_recovery_failed(void)
{
    tcp_uart_health_print("recovery failed", &recovery_uart_before);
    printf("[tcp recovery] failed stage=%u elapsed=%lu ms connect_seen=%u ok_seen=%u; retry later\r\n",
           (unsigned int)recovery_state,
           (unsigned long)(uint32_t)(board_systick_ms - recovery_started_ms),
           (unsigned int)recovery_connect_seen, (unsigned int)recovery_ok_seen);
    recovery_state = TCP_RECOVERY_IDLE;
    tcp_connected = TCP_FAIL;
    recovery_started_ms = board_systick_ms;
    recovery_wait_ms = (recovery_attempts >= 3U) ? 30000U : 5000U;
}

void tcp_recovery_note_ack(uint8_t success)
{
    /* 跳过恢复期间的 CAN 回退，只有实际尝试 TCP 的结果才由调用方上报。 */
    if(success != 0U)
    {
        if((recovery_attempts != 0U) || (recovery_ack_misses != 0U))
        {
            printf("[tcp recovery] business ACK verified\r\n");
        }
        recovery_attempts = 0U;
        recovery_ack_misses = 0U;
    }
    else
    {
        if(recovery_ack_misses < 5U)
        {
            recovery_ack_misses++;
        }
        if(recovery_ack_misses >= 5U)
        {
            tcp_connected = TCP_FAIL;
        }
    }
}

uint8_t tcp_recovery_service(void)
{
    esp12s_response_t response;
    uint8_t finished = 0U;
    uint8_t count;
    tcp_recovery_state_t next;

    if(tcp_saved_config == NULL)
    {
        return TCP_FAIL;
    }
    tcp_diagnostic_print();
    /* 限制每轮消费数量，保持 CAN/OTA 队列能够继续处理。 */
    for(count = 0U; count < 16U; count++)
    {
        if(esp12s_response_get(&response) == 0U)
        {
            break;
        }
        printf("[tcp recovery] stage=%u response=%s (%u)\r\n",
               (unsigned int)recovery_state, tcp_response_name(response),
               (unsigned int)response);
        if(response == ESP12S_RESPONSE_WIFI_CONNECTED)
        {
            wifi_connected = TCP_SUCCESS;
        }
        if(recovery_state == TCP_RECOVERY_IDLE)
        {
            if(response == ESP12S_RESPONSE_READY)
            {
                wifi_connected = TCP_FAIL;
            }
            if((response == ESP12S_RESPONSE_CLOSED) || (response == ESP12S_RESPONSE_READY))
            {
                tcp_connected = TCP_FAIL;
            }
            continue;
        }
        if(recovery_state == TCP_RECOVERY_RESET)
        {
            if(response == ESP12S_RESPONSE_READY)
            {
                finished = 1U;
            }
            continue;
        }
        /* 无连接时 CIPCLOSE 可回 ERROR；超时则不当作关闭成功。 */
        if((recovery_state == TCP_RECOVERY_CLOSE) &&
           (response == ESP12S_RESPONSE_ERROR))
        {
            finished = 1U;
            continue;
        }
        /* Read-only diagnostic commands may be unsupported by older ESP-AT. */
        if(((recovery_state == TCP_RECOVERY_ADDRESS) ||
            (recovery_state == TCP_RECOVERY_LOCAL_INFO) ||
            (recovery_state == TCP_RECOVERY_STATUS) ||
            (recovery_state == TCP_RECOVERY_AP) ||
            (recovery_state == TCP_RECOVERY_POWER) ||
            (recovery_state == TCP_RECOVERY_VERSION)) &&
           (response == ESP12S_RESPONSE_ERROR))
        {
            finished = 1U;
            continue;
        }
        if((response == ESP12S_RESPONSE_ERROR) || (response == ESP12S_RESPONSE_FAIL) ||
           (response == ESP12S_RESPONSE_BUSY) ||
           ((response == ESP12S_RESPONSE_CLOSED) && (recovery_state != TCP_RECOVERY_CLOSE)))
        {
            tcp_recovery_failed();
            return TCP_FAIL;
        }
        if(response == ESP12S_RESPONSE_CONNECT) recovery_connect_seen = 1U;
        if(response == ESP12S_RESPONSE_OK) recovery_ok_seen = 1U;
        if((recovery_ok_seen != 0U) &&
           ((recovery_state != TCP_RECOVERY_CONNECT) || (recovery_connect_seen != 0U)))
        {
            finished = 1U;
        }
    }
    if(recovery_state == TCP_RECOVERY_IDLE)
    {
        if((tcp_connected == TCP_FAIL) &&
           ((uint32_t)(board_systick_ms - recovery_started_ms) >= recovery_wait_ms))
        {
            if(recovery_attempts < 3U)
            {
                recovery_attempts++;
                next = TCP_RECOVERY_CLOSE;
            }
            else
            {
                wifi_connected = TCP_FAIL;
                next = TCP_RECOVERY_RESET;
            }
            recovery_ack_misses = 0U;
            if(tcp_recovery_command(next) == TCP_FAIL) tcp_recovery_failed();
        }
        return TCP_FAIL;
    }
    if(finished == 0U)
    {
        if((uint32_t)(board_systick_ms - recovery_started_ms) >= recovery_wait_ms)
        {
            printf("[tcp recovery] TIMEOUT stage=%u limit=%lu ms\r\n",
                   (unsigned int)recovery_state, (unsigned long)recovery_wait_ms);
            tcp_recovery_failed();
        }
        return TCP_FAIL;
    }
    switch(recovery_state)
    {
        case TCP_RECOVERY_CLOSE: next = TCP_RECOVERY_CONNECT; break;
        case TCP_RECOVERY_RESET: next = TCP_RECOVERY_STATION; break;
        case TCP_RECOVERY_STATION: next = TCP_RECOVERY_JOIN; break;
        case TCP_RECOVERY_JOIN: next = TCP_RECOVERY_ADDRESS; break;
        case TCP_RECOVERY_ADDRESS: next = TCP_RECOVERY_LOCAL_INFO; break;
        case TCP_RECOVERY_LOCAL_INFO: next = TCP_RECOVERY_STATUS; break;
        case TCP_RECOVERY_STATUS: next = TCP_RECOVERY_AP; break;
        case TCP_RECOVERY_AP: next = TCP_RECOVERY_POWER; break;
        case TCP_RECOVERY_POWER: next = TCP_RECOVERY_VERSION; break;
        case TCP_RECOVERY_VERSION: next = TCP_RECOVERY_MUX; break;
        case TCP_RECOVERY_MUX: next = TCP_RECOVERY_MODE; break;
        case TCP_RECOVERY_MODE: next = TCP_RECOVERY_CONNECT; break;
        case TCP_RECOVERY_CONNECT:
            recovery_state = TCP_RECOVERY_IDLE;
            recovery_started_ms = board_systick_ms;
            recovery_wait_ms = 5000U;
            tcp_connected = TCP_SUCCESS;
            printf("[tcp recovery] connected; awaiting business ACK\r\n");
            return TCP_SUCCESS;
        default: return TCP_FAIL;
    }
    if(tcp_recovery_command(next) == TCP_FAIL) tcp_recovery_failed();
    return TCP_FAIL;
}

static uint8_t tcp_deadline_expired(uint32_t deadline_ms)
{
    return ((uint32_t)(board_systick_ms - deadline_ms) < 0x80000000U) ? TCP_SUCCESS : TCP_FAIL;
}

/*
    等待一条命令的最终结果。普通命令只需要OK；CIPSTART除了OK，还必须等到CONNECT。
    WIFI CONNECTED和WIFI GOT IP是连接过程提示，不是本步骤的最终成功结果，所以这里继续等待OK。
*/
static uint8_t tcp_wait_response(uint8_t wait_connect, uint32_t timeout_ms)
{
    uint32_t deadline_ms = board_systick_ms + timeout_ms;
    uint8_t connect_received = TCP_FAIL;
    uint8_t ok_received = TCP_FAIL;
    esp12s_response_t response;
    esp12s_uart_health_t uart_before;
    esp12s_uart_health_get(&uart_before);

    while(tcp_deadline_expired(deadline_ms) == TCP_FAIL)
    {
        tcp_diagnostic_print();
        if(esp12s_response_get(&response) == 0U)
        {
            /*
                没有新事件时让出 1ms，不要纯自旋。
                这里最长要等 5 秒（重连）甚至 50 秒（开机 CWJAP），
                自旋会一直占着 CPU，把同优先级的采集和 HMI 一起拖慢。
                一行 AT 回应大约 1.7ms 就到齐，1ms 轮询足够。
            */
            vTaskDelay(pdMS_TO_TICKS(1U));
            continue;
        }

        if(response == ESP12S_RESPONSE_ERROR)
        {
            printf("ESP response: ERROR\r\n");
            return TCP_FAIL;
        }
        if(response == ESP12S_RESPONSE_FAIL)
        {
            printf("ESP response: FAIL\r\n");
            return TCP_FAIL;
        }
        if(response == ESP12S_RESPONSE_CLOSED)
        {
            /* MCU复位不会复位ESP，入网时可能先收到上一次TCP连接的异步关闭通知。
               普通AT命令仍应等待本命令的OK/ERROR/FAIL；只有CIPSTART等待CONNECT时，
               CLOSED才表示本次建连已经失败。 */
            if(wait_connect == TCP_SUCCESS)
            {
                printf("ESP response: CLOSED during TCP connect\r\n");
                return TCP_FAIL;
            }

            printf("ESP response: CLOSED ignored before TCP connect\r\n");
            continue;
        }
        if(response == ESP12S_RESPONSE_BUSY)
        {
            printf("ESP response: BUSY\r\n");
            return TCP_FAIL;
        }

        if(wait_connect == TCP_FAIL)
        {
            if(response == ESP12S_RESPONSE_OK)
            {
                return TCP_SUCCESS;
            }

           if(response == ESP12S_RESPONSE_WIFI_CONNECTED)
            {
                wifi_connected = TCP_SUCCESS;
            }

            continue;
        }

        if(response == ESP12S_RESPONSE_CONNECT)
        {
            connect_received = TCP_SUCCESS;
        }
        else if(response == ESP12S_RESPONSE_OK)
        {
            ok_received = TCP_SUCCESS;
        }

        if((connect_received == TCP_SUCCESS) && (ok_received == TCP_SUCCESS))
        {
            return TCP_SUCCESS;
        }
    }

    printf("ESP response: TIMEOUT\r\n");
    tcp_uart_health_print("AT timeout", &uart_before);
    return TCP_FAIL;
}

/*
    每发一条新命令都先丢弃旧回应，避免上一条命令残留的OK被误用。
    随后直接等待这条命令的结果，因此这里是阻塞点；等待期间USART1中断和SysTick中断仍能正常运行。
*/
static uint8_t tcp_command_send_and_wait_ok(const char *command, uint32_t timeout_ms)
{
    esp12s_response_reset();
    esp12s_cmd_send(command);
    return tcp_wait_response(TCP_FAIL, timeout_ms);
}

/*
    CIPSTART与普通命令不同：ESP一般会连续返回CONNECT和OK。
    两个回应都拿到，才说明TCP已经真正建立。
*/
static uint8_t tcp_connect_start_and_wait(const char *command)
{
    esp12s_response_reset();
    printf("[tcp init] command=%s", command);
    esp12s_cmd_send(command);
    return tcp_wait_response(TCP_SUCCESS, TCP_AT_TIMEOUT_MS);
}

/* SSID、密码和服务器文本会直接拼入AT命令，因此不允许引号或换行改变命令原本的边界。 */
static uint8_t tcp_at_text_valid(const char *text)
{
    uint16_t index = 0U;

    while(text[index] != '\0')
    {
        if((text[index] == '"') || (text[index] == '\r') || (text[index] == '\n'))
        {
            return TCP_FAIL;
        }
        index++;
    }

    return TCP_SUCCESS;
}

/*
    CIPSEND后ESP返回单字符'>'，表示接下来可以按指定长度发送原始数据。
*/
static uint8_t tcp_wait_prompt(uint32_t timeout_ms)
{
    uint32_t deadline_ms = board_systick_ms + timeout_ms;
    esp12s_response_t response;

     while(tcp_deadline_expired(deadline_ms) == TCP_FAIL)
    {
        if(esp12s_response_get(&response) == 0U)
        {
            /*
                没有新事件时让出 1ms，不要纯自旋。
                这里最长要等 5 秒（重连）甚至 50 秒（开机 CWJAP），
                自旋会一直占着 CPU，把同优先级的采集和 HMI 一起拖慢。
                一行 AT 回应大约 1.7ms 就到齐，1ms 轮询足够。
            */
            vTaskDelay(pdMS_TO_TICKS(1U));
            continue;
        }

        if(response == ESP12S_RESPONSE_PROMPT)
        {
            return TCP_SUCCESS;  // 收到 '>'，现在可发送 Frame
        }

        if((response == ESP12S_RESPONSE_ERROR) ||
           (response == ESP12S_RESPONSE_FAIL) ||
           (response == ESP12S_RESPONSE_BUSY) ||
           (response == ESP12S_RESPONSE_CLOSED))
        {
            printf("[tcp send] CIPSEND prompt failed response=%s (%u)\r\n",
                   tcp_response_name(response), (unsigned int)response);
            return TCP_FAIL;
        }
    }
    printf("[tcp send] CIPSEND prompt TIMEOUT limit=%lu ms\r\n", (unsigned long)timeout_ms);
    return TCP_FAIL;//超时返回fail
}

static uint8_t tcp_wait_send_ok(uint32_t timeout_ms)
{
    uint32_t deadline_ms = board_systick_ms + timeout_ms;
    esp12s_response_t response;

    while(tcp_deadline_expired(deadline_ms) == TCP_FAIL)
    {
        if(esp12s_response_get(&response) == 0U)
        {
            /*
                没有新事件时让出 1ms，不要纯自旋。
                这里最长要等 5 秒（重连）甚至 50 秒（开机 CWJAP），
                自旋会一直占着 CPU，把同优先级的采集和 HMI 一起拖慢。
                一行 AT 回应大约 1.7ms 就到齐，1ms 轮询足够。
            */
            vTaskDelay(pdMS_TO_TICKS(1U));
            continue;
        }

        if(response == ESP12S_RESPONSE_SEND_OK)
        {
            return TCP_SUCCESS;
        }

        if((response == ESP12S_RESPONSE_ERROR) ||
           (response == ESP12S_RESPONSE_FAIL) ||
           (response == ESP12S_RESPONSE_BUSY) ||
           (response == ESP12S_RESPONSE_CLOSED))
        {
            printf("[tcp send] SEND OK failed response=%s (%u)\r\n",
                   tcp_response_name(response), (unsigned int)response);
            return TCP_FAIL;
        }
    }

    printf("[tcp send] SEND OK TIMEOUT limit=%lu ms\r\n", (unsigned long)timeout_ms);
    return TCP_FAIL;
}

uint8_t tcp_init(const tcp_config_struct *config)
{
    int command_length;

    if((config == 0) || (config->wifi_ssid == 0) || (config->wifi_password == 0) ||
       (config->server_ip == 0) || (config->server_port == 0U) ||
       (config->wifi_ssid[0] == '\0') || (config->server_ip[0] == '\0'))
    {
        printf("TCP init failed: invalid WiFi or server configuration\r\n");
        return TCP_FAIL;
    }

    if((tcp_at_text_valid(config->wifi_ssid) == TCP_FAIL) ||
       (tcp_at_text_valid(config->wifi_password) == TCP_FAIL) ||
       (tcp_at_text_valid(config->server_ip) == TCP_FAIL))
    {
        printf("TCP init failed: configuration contains unsupported character\r\n");
        return TCP_FAIL;
    }

    /* 只有配置通过校验才记住，供 tcp_try_reconnect() 复用。 */
    tcp_saved_config = config;
    recovery_state = TCP_RECOVERY_IDLE;
    recovery_attempts = 0U;
    recovery_ack_misses = 0U;
    recovery_started_ms = board_systick_ms;
    recovery_wait_ms = 5000U;

    /* BOARD先配置USART1的NVIC和SysTick；这里才初始化ESP12S的USART1硬件。 */
    esp12s_init();
    printf("[tcp init] USART1 configured PA2/PA3 115200; testing ESP AT\r\n");
    tcp_connected = TCP_FAIL;
    /* 重连或重试时必须先摘掉旧牌子，否则HMI会显示上一次的在线状态。 */
    wifi_connected = TCP_FAIL;

    if(tcp_command_send_and_wait_ok(ESP_AT_TEST, TCP_AT_TIMEOUT_MS) == TCP_FAIL)
    {
        printf("TCP init failed: ESP-AT test command did not return OK\r\n");
        return TCP_FAIL;
    }

    printf("[tcp init] ESP AT responded OK\r\n");
    if(tcp_command_send_and_wait_ok("AT+CWMODE=1\r\n", TCP_AT_TIMEOUT_MS) == TCP_FAIL)
    {
        printf("TCP init failed: cannot set ESP station mode\r\n");
        return TCP_FAIL;
    }

    command_length = snprintf(tcp_command_buffer, sizeof(tcp_command_buffer),
                              "AT+CWJAP=\"%s\",\"%s\"\r\n",
                              config->wifi_ssid, config->wifi_password);
    if((command_length < 0) || ((uint32_t)command_length >= sizeof(tcp_command_buffer)) ||
       (tcp_command_send_and_wait_ok(tcp_command_buffer, TCP_WIFI_JOIN_TIMEOUT_MS) == TCP_FAIL))
    {
        printf("TCP init failed: WiFi join command failed or timed out\r\n");
        return TCP_FAIL;
    }
    uint8_t i = 0U;
    for(i = 0U; i < (TCP_SSID_SIZE - 1U); i++)
    {
        tcp_ssid_saved[i] = config->wifi_ssid[i];

        if(config->wifi_ssid[i] == '\0')
        {
            break;                                  /* ← 碰到结尾就停 */
        }
    }
    tcp_ssid_saved[i] = '\0';                       /* ← 抄满时兜底 */

    if(tcp_command_send_and_wait_ok(ESP_AT_CIFSR, TCP_AT_TIMEOUT_MS) == TCP_FAIL)
    {
        printf("TCP init failed: cannot query ESP network address\r\n");
        return TCP_FAIL;
    }
    (void)tcp_command_send_and_wait_ok("AT+CIPSTA?\r\n", TCP_AT_TIMEOUT_MS);
    (void)tcp_command_send_and_wait_ok("AT+CIPSTATUS\r\n", TCP_AT_TIMEOUT_MS);
    (void)tcp_command_send_and_wait_ok("AT+CWJAP?\r\n", TCP_AT_TIMEOUT_MS);
    (void)tcp_command_send_and_wait_ok("AT+SLEEP?\r\n", TCP_AT_TIMEOUT_MS);
    (void)tcp_command_send_and_wait_ok("AT+GMR\r\n", TCP_AT_TIMEOUT_MS);

    if(tcp_command_send_and_wait_ok("AT+CIPMUX=0\r\n", TCP_AT_TIMEOUT_MS) == TCP_FAIL)
    {
        printf("TCP init failed: cannot select single TCP connection mode\r\n");
        return TCP_FAIL;
    }

    if(tcp_command_send_and_wait_ok("AT+CIPMODE=0\r\n", TCP_AT_TIMEOUT_MS) == TCP_FAIL)
    {
        printf("TCP init failed: cannot select normal TCP transmission mode\r\n");
        return TCP_FAIL;
    }

    command_length = snprintf(tcp_command_buffer, sizeof(tcp_command_buffer),
                              "AT+CIPSTART=\"TCP\",\"%s\",%u\r\n",
                              config->server_ip, (unsigned int)config->server_port);
    if((command_length < 0) || ((uint32_t)command_length >= sizeof(tcp_command_buffer)) ||
       (tcp_connect_start_and_wait(tcp_command_buffer) == TCP_FAIL))
    {
        printf("TCP init failed: cannot connect to TCP server\r\n");
        return TCP_FAIL;
    }

    tcp_connected = TCP_SUCCESS;
    return TCP_SUCCESS;
}

uint8_t tcp_connected_get(void)
{
    return tcp_connected;
}

/*
    运行期断线重连：ESP 断开的只是到服务器的 TCP 连接，
    Station 模式与 WiFi 仍然在线，所以这里只需要重发一条 CIPSTART 重建连接。

    成功返回 TCP_SUCCESS 并恢复在线状态；失败返回 TCP_FAIL，由调用方稍后再试。
    调用者必须给重连加冷却（见 TransmitTask 的 TCP_RECONNECT_COOLDOWN_MS），
    否则网关一直不在时每条记录都会卡在这条 CIPSTART 上。
*/
uint8_t tcp_try_reconnect(void)
{
    int command_length;

    if((tcp_saved_config == 0) ||
       (tcp_saved_config->server_ip == 0) ||
       (tcp_saved_config->server_port == 0U))
    {
        return TCP_FAIL;
    }

    command_length = snprintf(tcp_command_buffer, sizeof(tcp_command_buffer),
                              "AT+CIPSTART=\"TCP\",\"%s\",%u\r\n",
                              tcp_saved_config->server_ip,
                              (unsigned int)tcp_saved_config->server_port);
    if((command_length < 0) ||
       ((uint32_t)command_length >= sizeof(tcp_command_buffer)))
    {
        return TCP_FAIL;
    }

    esp12s_response_reset();
    esp12s_cmd_send(tcp_command_buffer);

    if(tcp_wait_response(TCP_SUCCESS, TCP_RECONNECT_TIMEOUT_MS) == TCP_FAIL)
    {
        tcp_connected = TCP_FAIL;
        return TCP_FAIL;
    }

    tcp_connected = TCP_SUCCESS;
    return TCP_SUCCESS;
}

/*
    这个函数调用BSP层接口返回供上层调用发送数据
*/
uint8_t tcp_data_send(const uint8_t *data, uint8_t length)
{
    int command_length;

    if((data == NULL) || (length == 0U) || (tcp_connected == TCP_FAIL) ||
       (recovery_state != TCP_RECOVERY_IDLE))
    {
        return TCP_SEND_FAIL;
    }

    /*
        snprintf() 的作用是按照指定格式生成字符串，并将结果写入指定的字符数组中。
        第一个参数 tcp_command_buffer：
            用于保存最终生成的字符串，也就是我们的 TCP AT 指令发送缓冲区。
        第二个参数 sizeof(tcp_command_buffer)：
            表示缓冲区最大可写入的长度，用来防止字符串写出数组边界。
        第三个参数 "%s%u\r\n"：
            是字符串格式。
            %s 用于填入字符串 ESP_AT_CIPSEND，
            %u 用于填入无符号整数 length，
            \r\n 是 AT 指令要求的结束符。
    这样做我们就可以发送"AT+CIPSEND= "length""的格式了，之前我们使用定义一个只有一位的数组存储length，这是错误的
    */
    command_length = snprintf(tcp_command_buffer, sizeof(tcp_command_buffer),
                              "%s%u\r\n", ESP_AT_CIPSEND, (unsigned int)length);
    if((command_length < 0) || ((uint32_t)command_length >= sizeof(tcp_command_buffer)))
    {
        return TCP_SEND_FAIL;
    }

    /* 新命令开始前清除旧事件，避免上次传输残留的回应被本次误用。 */
    esp12s_response_reset();
    esp12s_cmd_send(tcp_command_buffer);//然后将我们拼接好的进行发送

    if(tcp_wait_prompt(TCP_AT_TIMEOUT_MS) == TCP_FAIL)
    {
        tcp_connected = TCP_FAIL;
        return TCP_SEND_FAIL;
    }
    esp12s_data_send(data, length);

    if(tcp_wait_send_ok(TCP_AT_TIMEOUT_MS) == TCP_FAIL)
    {
        tcp_connected = TCP_FAIL;
        return TCP_SEND_FAIL;
    }
    return TCP_SEND_SUCCESS;
}

uint8_t wifi_state_get(void)
{
    return wifi_connected;
}

/* 内部已经做好不用再写逻辑了 */
uint8_t tcp_local_ip_get(char *buffer, uint8_t size)
{
    return esp12s_local_ip_get(buffer, size);
}

uint8_t tcp_ssid_get(char *buffer,uint8_t size)
{
    if(buffer == NULL || size <= 0)
    {
        return 0U;
    }
    uint8_t i;
    for(i = 0;i < size;i++)
    {
        buffer[i] = tcp_ssid_saved[i];
        if(tcp_ssid_saved[i] == '\0')
        {
            break;
        }
    }
    if(i >= size)
    {
        buffer[size - 1U] = '\0';
    }
    return 1U;
}
