xccloop/EdgeLink/(commit log)

2026-08-27 epoll基础骨架写完，tcp未进行适配，epoll类未升级
2026-08-29 epoll+tcp非阻塞源文件V0.1完成
2026-08-29 非阻塞ET客户端代码V0.1实现 包含客户端独立缓冲区，epoll管理TCP
2026-08-29 新增简单的CRC校验，今天到此为止，查表法又要去绕逻辑，等固定帧协议之后在进行
2026-09-02 CRC校验+TCP通信+Epoll ET+Ringbuffer缓冲区+frame自定义帧协议解析器完成，当前并不支持发送自定义帧协议
2026-09-03 main函数初次建立服务端已完成，接下来是处理客户端已经异常错误即器退出
2026-09-04 TCP协议自定义帧修改更贴近真实情况，内部统一消息模型确定，接下来将消息模型信息存储进SQLite
2026-09-05 项目接入SQLite，实现创建库+创建表+插入数据，TCP数据接受链路完成
2026-09-06 can基本骨架熟悉，下一步封装为类
2026-09-07 Can封装完成，下一步时加入到main中
2026-09-07 Can接入epoll循环，can协议帧内部统一消息模型并最终存储到sqlite中
2026-09-08 项目环境初步搭建完毕，LED驱动部分完毕
2026-09-08 EXTI中断+标志位的KEY实现
2026-09-08 ch340串口初始化写完，gpio口输出概念修改
2026-09-09 ch340串口完成
2026-09-09 ESP12S硬件基础搭建完成
2026-09-09 ADC流程解析，暂时未实现
2026-09-10 Add board-level configuration and peripheral foundations
2026-09-10 Align board time delay declaration
2026-09-10 ADC驱动完成
2026-09-11 BMP280初版完成
2026-09-11 SPI发送接受函数新增成功失败校验，BMP280上层功能对应适配
2026-09-11 CAN BSP完成
2026-09-12 外置FLASH BSP实现
2026-09-12 IPS BSP完成
2026-09-12 IPS接入双行缓冲
2026-09-12 采集APP层封装完成
2026-09-12 TCP 初始化完成
2026-09-13 TCP帧协议封装完成
2026-09-13 CAN协议发送封装完成
2026-09-13 存储层完成
2026-09-13 裸机总初始化完成
2026-09-13 APP层分层结构重构
2026-09-13 edgenode开始软硬联调,新增flash.psl进行一键编译烧录,printf重定向函数写错已修正,EXTI中断函数末尾加入清除中断标志
2026-09-14 修复BMP280直接返回float温度，GD25&BMP280上电后争抢CS
    修正为返回整数未缩放的温度+缩放值方便collection层管理
    增加board_spi0_device_cs_safe_state保证上电后CS不发生冲突
2026-09-15 fix(CAN过滤的帧把edgenode的canid也过滤了)
2026-09-15 (fix)ESP12S联网时可能先收到上一次TCP连接的异步关闭通知。导致显示连接失败
2026-09-15 (fix)修复ctrl+c无法退出
2026-09-15 (feat)2026-09-15调试笔记写入
2026-09-15 (fix)补全transmit层tcp发送
2026-09-16 (feat)config可配置wifi初始化结构体
2026-09-16 (fix)transmit层can链路打通
2026-09-16 (feat)main循环接受数据打印
2026-09-16 创建Gateruntime替代原有的main冗长循环，细化函数API
2026-09-16 (feat)Freertos源码，未移植，2026-09-16笔记更新
2026-09-17 (feat)FreeRtos初步移植完毕，led交替闪烁测试通过
2026-09-17 (feat)2026-09-17笔记更新
2026-09-18 (feat)storage重构，message接入squence
2026-09-18 (feat)message采用队列进行跨任务获取
2026-09-18 (feat)节点协议新增ACK解码
2026-09-18 (feat)SPI0使用互斥锁
2026-09-18 (feat)hub适配node 传输协议，新增ACK回应机制，SQLite查重机制
2026-09-19 (feat)transmit/storage/collect任务完成
2026-09-19 (feat)transmit任务增加ACK应答
2026-09-20 feat(storage): 优化开机扫描并新增回环日志处理
2026-09-21 fix(storage): 修复上电后只会发送一条 pending
2026-09-22 fix(transmit): 修复运行途中 TCP 不会自动重连，新增重连后发送 pending
    问题：节点只在开机时建立一次 TCP，链路断开（如网关重启）后不再重连，
    发送一路失败，积压的 pending 只能等下次上电才补，运行途中的补发缺口一直存在。
    改动：
    - tcp.c/h：tcp_init() 保存已校验的配置，新增 tcp_try_reconnect()，
    只重发 AT+CIPSTART 重建连接，超时缩短到 5s。
    - storage.c/h：新增 storage_find_oldest_pending()，复用绕回搜索找地址最旧的一条 pending。
    - rtos_task.c：抽出 storage_replay_pending()（上电恢复与运行期补发共用）；
    TransmitTask 在 TCP 发送失败时按 5s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
    [tcp.c, tcp.h]
2026-09-22 （feat）2026-09-22笔记更新
2026-09-23 feat(readme): 加入 PCB/原理图
2026-09-23 docs(readme): README 更新 — 当前边界改为验收通过（72h 无死机）
2026-09-24 (feat)hmi层第一版确定
2026-09-24 (feat)新增HMI基础任务
2026-09-25 (fix)IPS屏幕无法使用，HMI层重构
2026-09-26 (feat)HMI_RENDER层重构完成
2026-09-26 (chore)删除未使用的mcu-renderer第三方库
    和本项目逐行DMA、无整屏缓存的架构不对口，且无任何代码引用。
2026-09-26 (feat)HMI_PAGE层重构完成
2026-09-26 (fix)修复key中断与HMI的交互
2026-09-27 HMI_CONTROL层重构完成
2026-09-28 HMI层完成task，接入真实数据
2026-09-28 (fix)hmi:数据更新时连头部一起刷新，WI-FI状态不再停在开机时的UNKNOWN
2026-09-28 (fix)不管初始化是否正确都启动
2026-09-28 (chore)不再跟踪运行时数据库 edgehub.db
2026-09-28 (chore)加 .gitattributes：全线 LF，避免树莓派上脚本被写成 CRLF
2026-09-28 (fix)hub:build.sh 配 can0 时先 down 再 up，失败也不再掐断脚本
2026-09-28 (fix)运行中自动重连，不会阻塞其他任务
    网关重启后节点不再重连，TCP 一路失败，积压的 pending 只能等下次上电才补。
    - tcp.c/h：恢复 tcp_try_reconnect()（保存校验过的配置，只重发 CIPSTART，
    不重跑 CWJAP）；tcp_wait_response / tcp_wait_prompt / tcp_wait_send_ok
    的空轮询改成 vTaskDelay(1) 让出 CPU —— 原来最长会纯自旋 50 秒，
    把同优先级的采集和 HMI 一起拖慢。
    - rtos_task.c：TransmitTask 在 TCP 掉线时按 5 秒冷却试重连，成功后置
    link_restored；StorageTask 看到就把积压的 pending 全部补发一遍。
    这套逻辑在 33f1a5c 的重构里被误删，本次找回。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
    [tcp.c, tcp.h]
2026-09-28 (fix)hub:build.sh 不再配置 can0
    原来那条 `sudo ip link set can0 up type can bitrate 500000` 在接口已经 up 时
    必然失败（不能在线改波特率），而 set -e 会让脚本当场退出，Edgehub 也就起不来了。
    先前改成 down+up 绕开了这个报错，但引入了新副作用：每次编译运行都会把 CAN
    总线断开一下，而且每次都要 sudo。can0 是开机配一次的事，不该进 build 流程。
2026-09-29 (feat)edgedash新增main
2026-09-30 (feat)新增bootloader程序，boot_jump完成
2026-10-01 (feat)bootloader，镜像校验位完成
2026-10-01 (feat)OTA元数据区结构定义
2026-10-01 (feat)bootloader main骨架完成
2026-10-01 (feat)bootloader增加日志打印
2026-10-02 新增bootloader进入空转时增加IPS提示，修复systick进入应用后没有重新打开 新增连接脚本烧录APP到指定位置，bootloader初步测试通过
2026-10-02 (project)修正git仓库，IPS提取为Common
2026-10-03 (feat)新增CAN接收id分流区分bootloader固件
2026-10-03 refactor(storage):storage改名log，存储层分层结构更新
2026-10-05 feat(ota):决策层完成
2026-10-05 feat(ota):新增ota task
2026-10-06 feat(bootloader)新增bootloader上电后读取获取flash中存储固件
2026-10-06 refactor(FreeRtos_task)任务结构优化
2026-10-06 docs(README)文档更新
2026-10-07 feat(Http):新增http接受+发送
2026-10-07 feat(HttpHandle)新增业务处理逻辑，目前只实现最简单
2026-10-08 feat(http)http接入主循环，测试命令成功
2026-10-08 feat(http)新增crul查询节点空闲槽位命令
2026-10-08 feat(CAN)新增ota回应帧逻辑
2026-10-09 feat(http)新增crul下发固件命令，暂不支持异常处理
2026-10-09 refactor(edgehub)修正http与ota分层
2026-10-09 feat(edgelink)新增ota升级中的故障处理，480帧返回序列号
2026-10-10 feat(develop)新增开发笔记调试
2026-10-10 fix(edgenode)修复edgenode在运行过程中CAN重连不会补发
2026-10-10 docs(README)README增加OTA相关描述
2026-10-11 fix(edgenode)修复TCP重连为非阻塞分步连接
2026-10-11 feat(edgehub)适配龙芯2K0300：交叉编译、SQLite内嵌、CAN打通
    把 edgehub 从树莓派迁移到逐飞 LS2K0300（loongarch64）核心板。
    可移植性
    - inc/Can.hpp 补 #include <cstdint>：GCC 13+ 不再从 <string>/<vector> 捎带
    <cstdint>，本地 WSL（GCC 15）编不过；而 GCC 8.3 的交叉工具链反而能编。
    这种"编译器替我兜底"的状态必须消除
    - main.cpp 补 <csignal> / <cstdio>，不再依赖传递包含
    - Gateruntime.cpp 数据库路径从写死的 /home/qxc/Desktop/... 改成文件顶部常量
    kDbPath = "data/edgehub.db"，错误打印改用 %s 带上实际路径
    运行时可见性
    - main() 开头加 setvbuf(stdout, NULL, _IONBF, 0)。st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
2026-10-11 feat(edgenode)新增TCP网络诊断
2026-10-11 docs(develop)2026-10-11开发笔记更新
2026-10-11 feat(edgedash)新增Home页面展示，新增wifi连接状态显示
2026-10-12 feat(edgedash)新增TCP发送接受与HTTP请求与解析
2026-10-12 feat(edgenode)HMI新增当前固件版本显示
2026-10-12 fix(edgenode)修复edgenode IPS启动花屏的现象，修复接受固件后自动重启
2026-10-12 feat(edgenode)新增TCP OTA查询槽位帧
2026-10-12 feat(edgehub)新增TCP链路查询槽位
2026-10-12 docs(edgelink)新增10-12开发笔记，OTA日志记录
2026-10-13 feat(edgenode)新增tcp链路ota固件下发逻辑
2026-10-13 feat(edgehub)新增crul控制TCP下发固件逻辑
2026-10-13 fix(edgenode)修复edgenode的重连堵塞问题，将flash扫描pending改为分步式 使用数组保存某一页有pending随后再进行补发
2026-10-13 docs(develop)新增10-13开发笔记
2026-10-14 fix(edgenode)修复flash重连扫描pending采集，发送任务停止的问题
2026-10-14 docs(edgelink)README更新，edgehub新增子项目README
2026-10-14 feat(edgelink)新增下发固件的签名校验
2026-10-14 docs(edgelink)开发笔记更新，README更新
2026-10-15 feat(edgenode)edgenode新增flash卡死IPS提示
2026-10-16 feat(edgehub)新增crul查询历史节点
